yongyuxuuni/Prototyping/weekly lab report/May 15 Friday/lab report-May 15.docx

Lab Report

Date: May 15th , 2026

Team: E1

Team Members

Last name | First name | Email
Rahman | Md Mahbubur | md-mahbubur.rahman@stud.hshl.de
Sakib | Md Naimur Rahaman | md-naimur-rahaman.sakib@stud.hshl.de
Xu | Yongyu | yongyu.xu@stud.hshl.de
Koluacik | Baris | baris.koluacik@stud.hshl.de

Goal

Assemble the vehicle and test the sensors to ensure they are functioning properly.

Discussion

1. The motor is being pushed by a screw, but this has little effect, as shown in Figure 1.

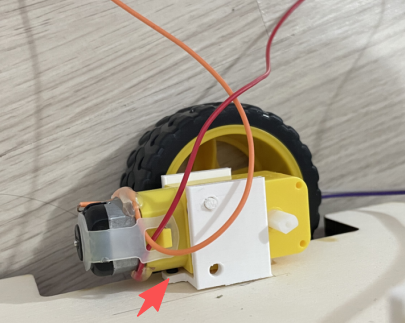
[picture p10: figure]
ee1fbc95-70e5-45c6-a6e3-75dcbe85ee12

Figure 1 The Motor Holder

2. The IR-Sensor Holders were not sturdy enough and broke during installation, it has been reprinted.
3. The chassis is too close to the ground, but no issues have been observed so far, as shown in Figure 2.

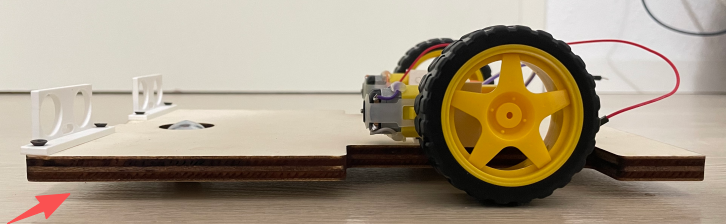
[picture p11: figure]
f93b4a24-a529-4bf4-97b0-87d33d0d764e

Figure 2 The chassis and ground

4. Both the IR-Sensors and the Ultrasonic-Sensors are functioning properly, please refer to the videos in the folder for details.

Prototyping - Summer Semester 2026
