yongyuxuuni/Prototyping/Task 1/physical schematic/Robot.pdf

L R

# HC-SR04

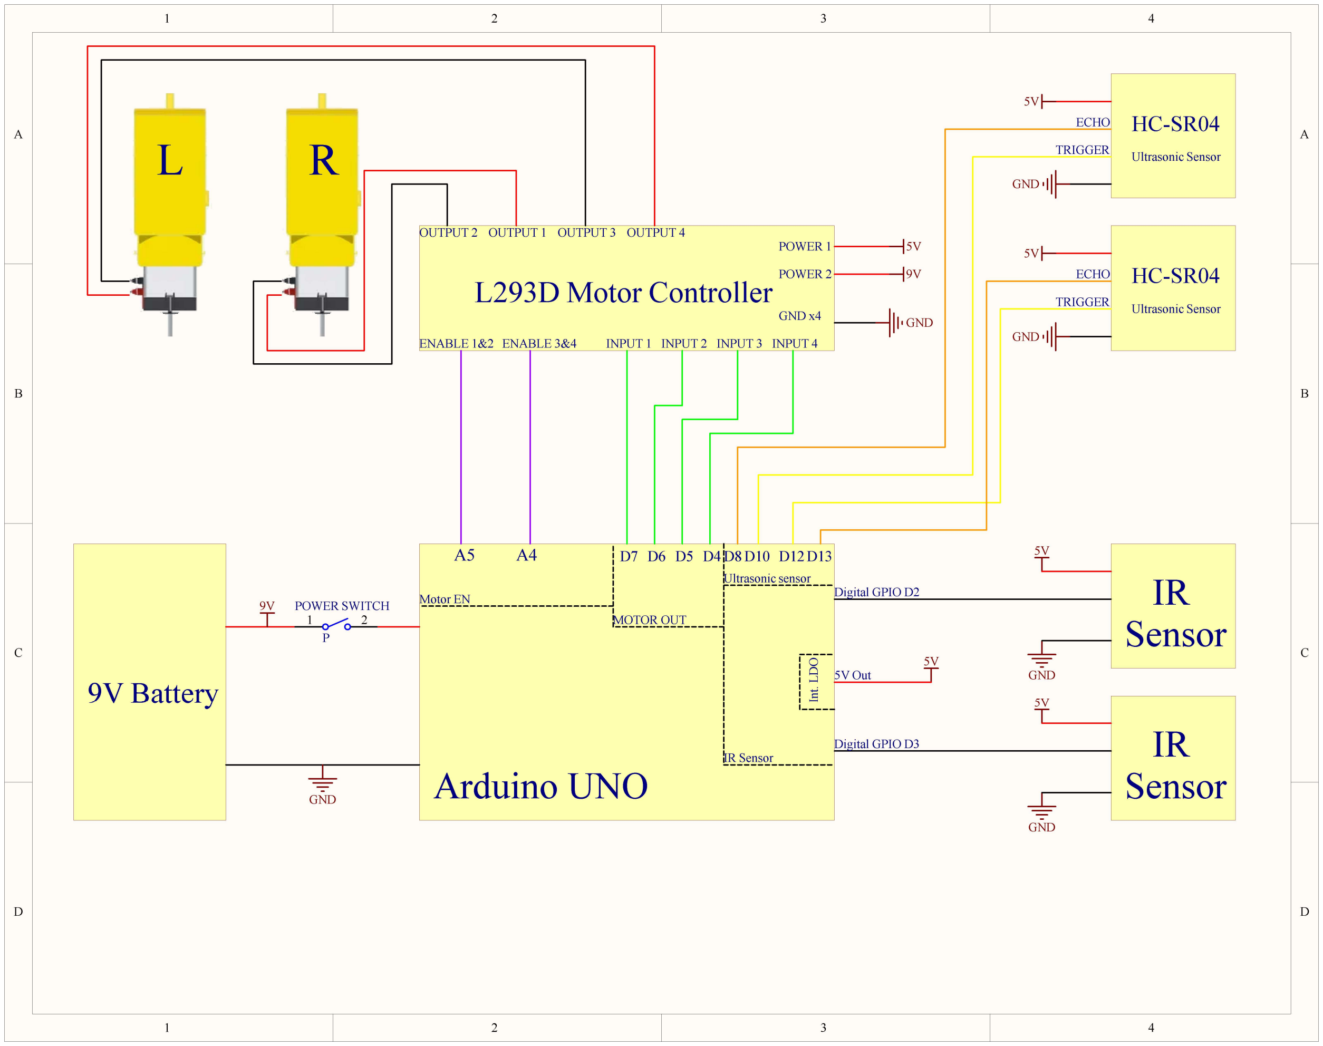
[picture p21: page 1]

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
# Arduino UNO

# 9V Battery

# L293D Motor Controller

IR

# Sensor

GND

GND

9V

5V

Digital GPIO D2

IR

# Sensor

GND

5V

Digital GPIO D3

1 2

POWER SWITCH

P
5V
5V Out
OUTPUT 2 | OUTPUT 3 OUTPUT 4 OUTPUT 1
POWER 1

POWER 2

5V

9V

GND x4 | GND

ENABLE 1&2 ENABLE 3&4

A5 A4

INPUT 1 INPUT 2 INPUT 3 INPUT 4

### D7 D6 D5 D4

Ultrasonic Sensor

5V

D8 D10

MOTOR OUT

D12 D13

ECHO

TRIGGER

GND

# HC-SR04

Ultrasonic Sensor

5V
ECHO

TRIGGER

GND

Ultrasonic sensor

IR Sensor Int. LDO

Motor EN
