yongyuxuuni/Prototyping/presentation/E1 presentation.pdf

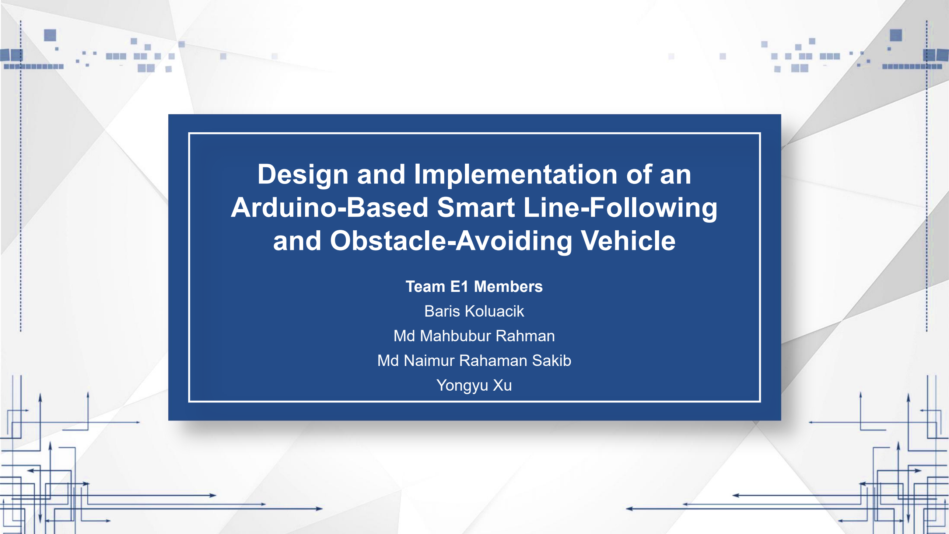
[picture p22: page 1]

# Design and Implementation of an Arduino-Based Smart Line-Following and Obstacle-Avoiding Vehicle

### Team E1 Members

Baris Koluacik
Md Mahbubur Rahman
Md Naimur Rahaman Sakib
Yongyu Xu

### https://www.ypppt.com/

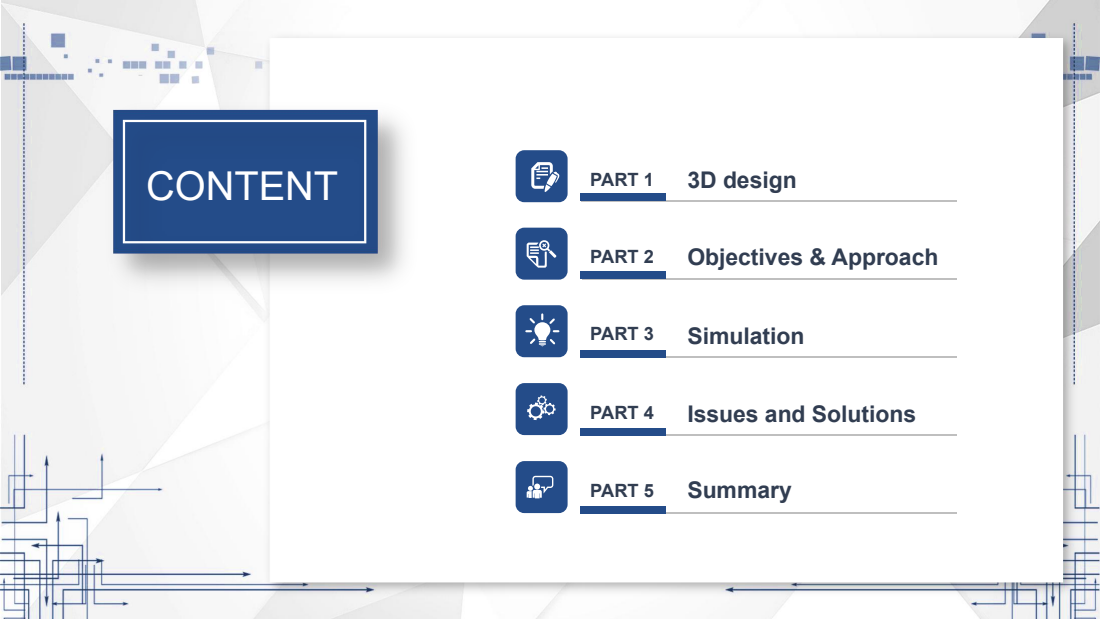
[picture p23: page 2]
CONTENT; PART 1; 3D design; PART 2; Objectives & Approach; PART 3; Simulation; PART 4; Issues and Solutions; PART 5; Summary

## PART 1 3D design

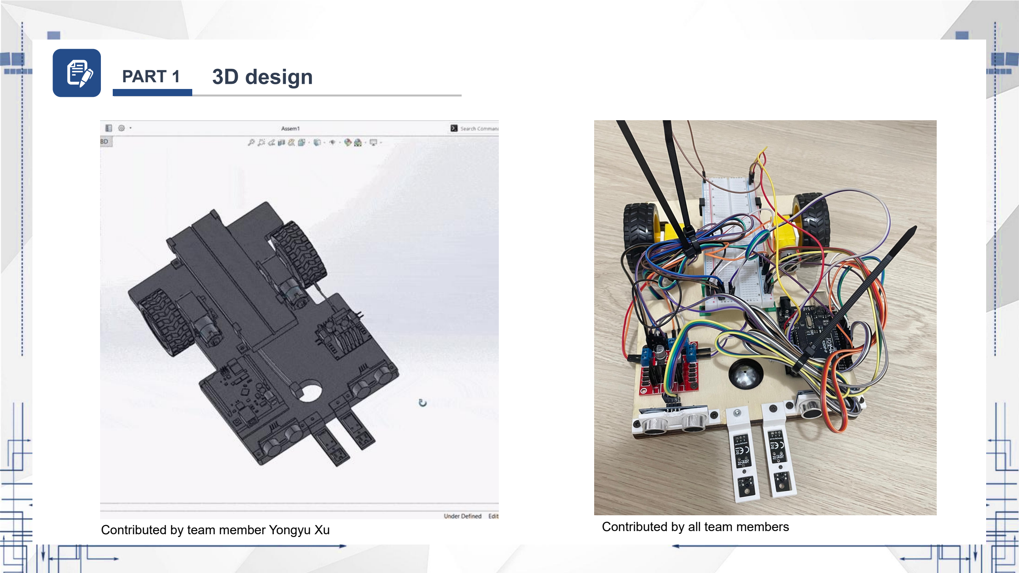
[picture p24: page 3]

Contributed by team member Yongyu Xu | Contributed by all team members

## PART 2 Objectives&Approach

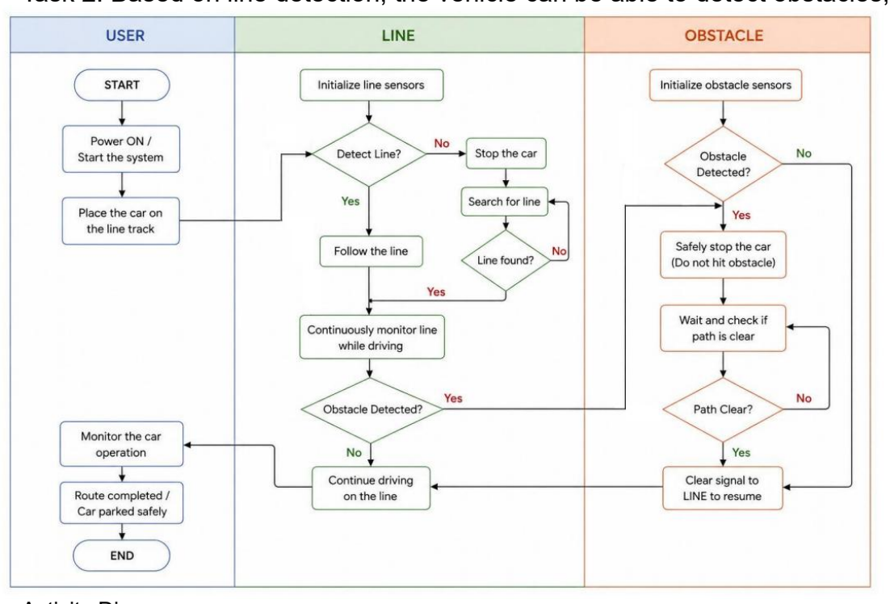
[picture p25: figure]

Activity Diagram
Contributed by team member Md Naimur Rahaman Sakib

Objectives：
Task 1: Develop an autonomous vehicle that can drive autonomously on a given track. Task 2: Based on line detection, the vehicle can be able to detect obstacles, avoid, search track. l Yes-> Stop-> Turn-> Continue tracking

l No-> Line tracking mode

## Obstacle avoidance mode

l Read IR sensors-> Move forward/Turn -> Continue tracking

## Line following mode

## PART 2 Objectives&Approach

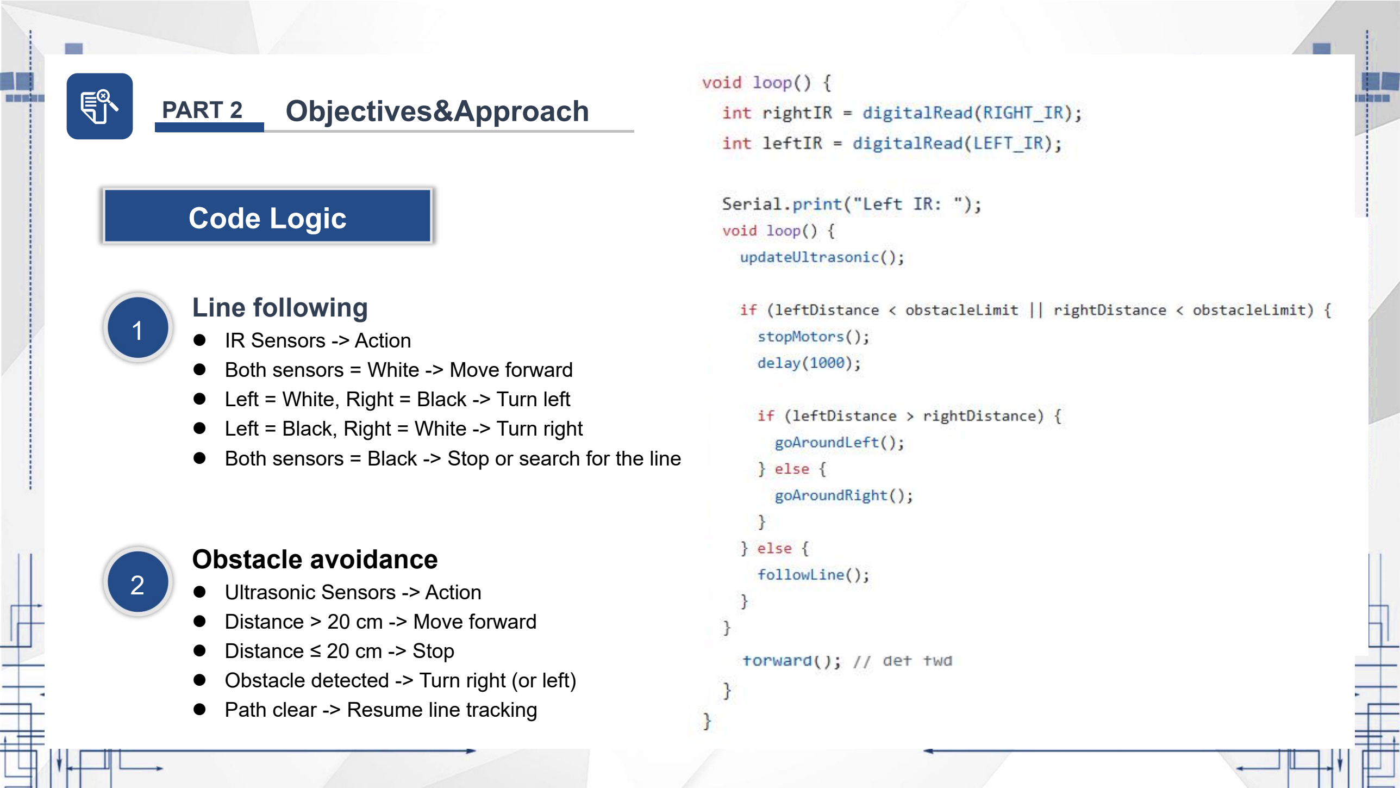
[picture p26: page 5]

1

## Line following

l IR Sensors -> Action
l Both sensors = White -> Move forward
l Left = White, Right = Black -> Turn left
l Left = Black, Right = White -> Turn right
l Both sensors = Black -> Stop or search for the line

2

## Obstacle avoidance

l Ultrasonic Sensors -> Action
l Distance > 20 cm -> Move forward
l Distance ≤ 20 cm -> Stop
l Obstacle detected -> Turn right (or left) l Path clear -> Resume line tracking

## Code Logic

## PART 2 Objectives&Approach

## Wiring Logic

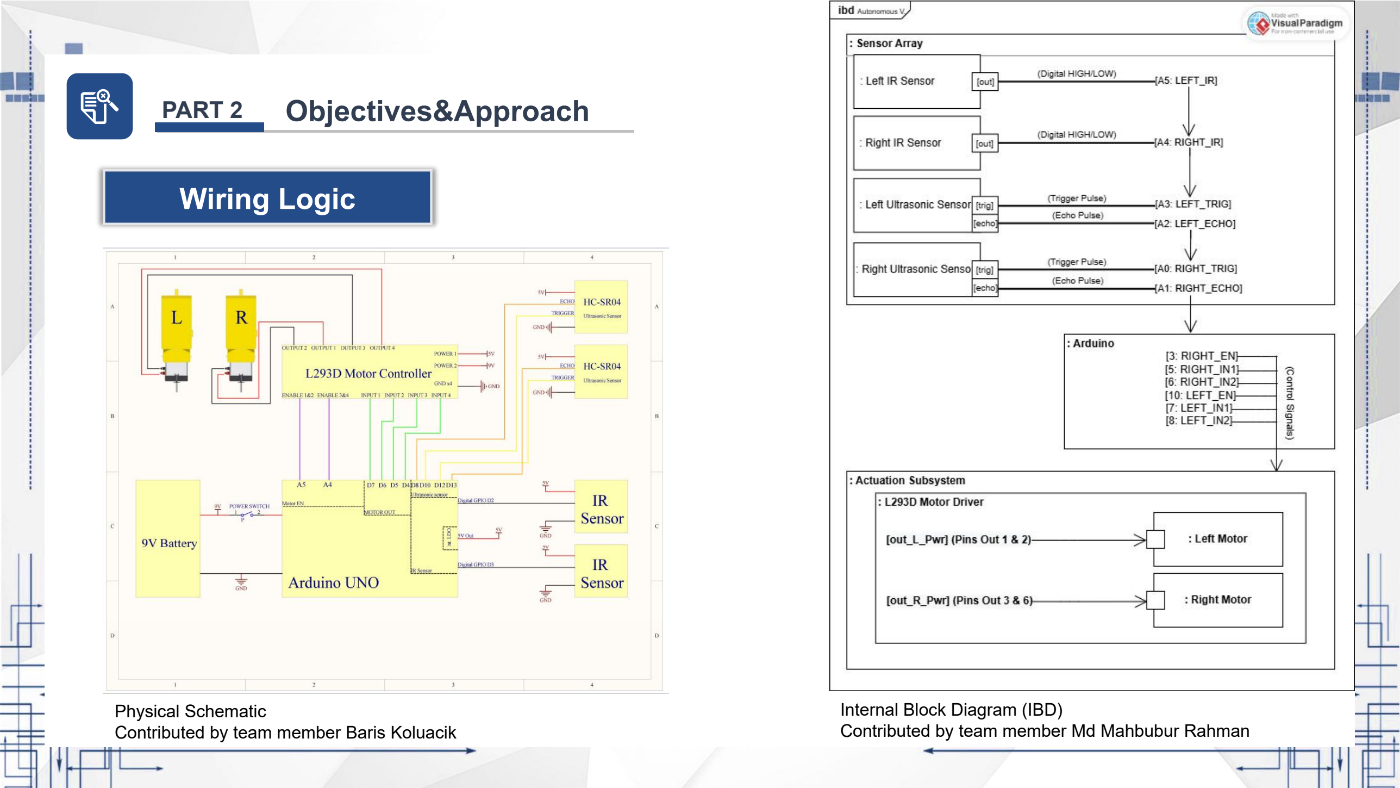
[picture p27: page 6]

Internal Block Diagram (IBD)
Contributed by team member Md Mahbubur Rahman

Physical Schematic
Contributed by team member Baris Koluacik

## PART 3 Simulation

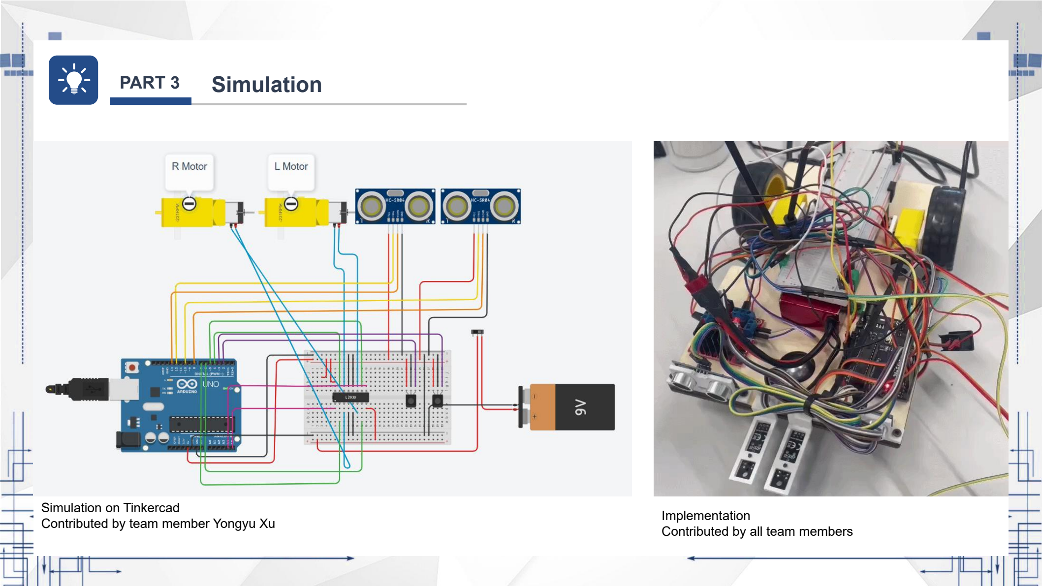
[picture p28: page 7]

Simulation on Tinkercad
Contributed by team member Yongyu Xu

Implementation
Contributed by all team members

## PART 4 Issues and Solutions

## Issues for Task 1

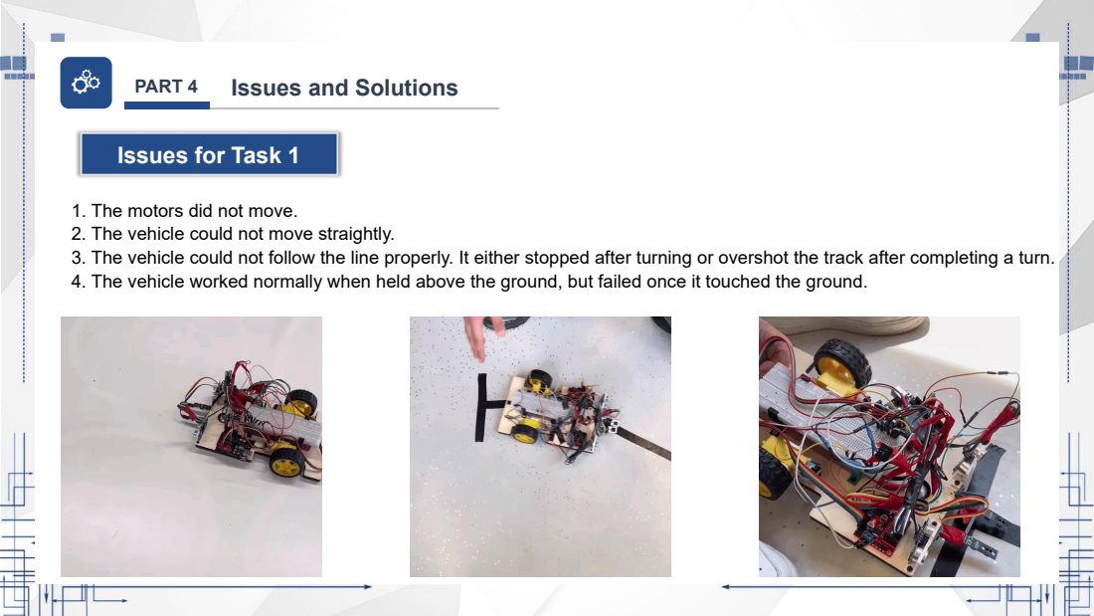
[picture p29: page 8]

1. The motors did not move. 2. The vehicle could not move straightly. 3. The vehicle could not follow the line properly. It either stopped after turning or overshot the track after completing a turn. 4. The vehicle worked normally when held above the ground, but failed once it touched the ground.

## PART 4 Issues and Solutions

## Wiring

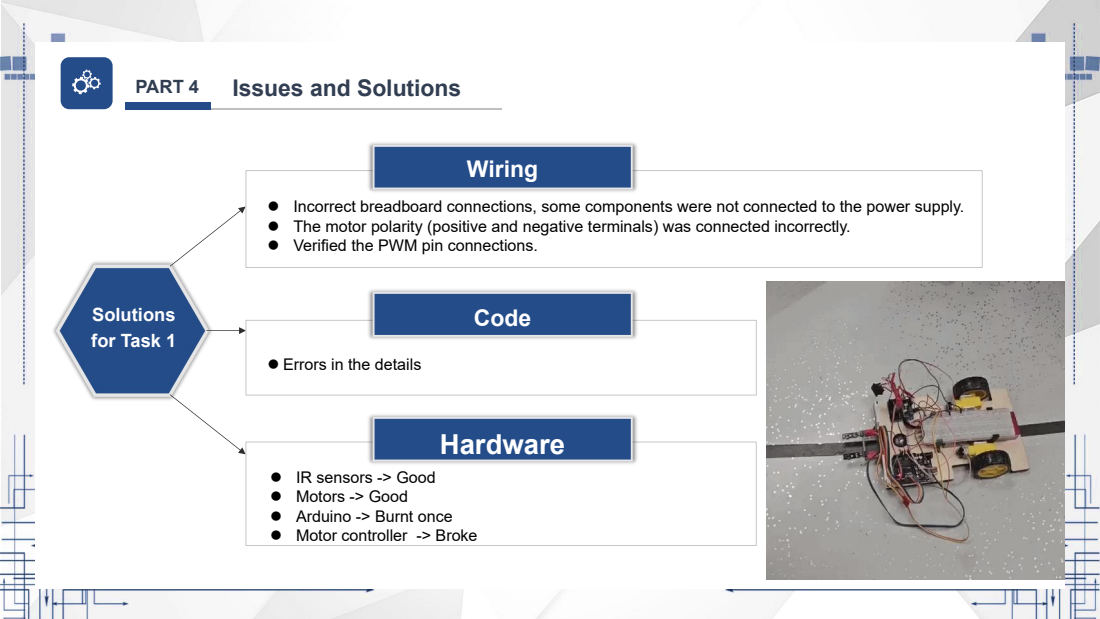
[picture p30: page 9]
Hardware; Solutions for Task 1

l Incorrect breadboard connections, some components were not connected to the power supply. l The motor polarity (positive and negative terminals) was connected incorrectly. l Verified the PWM pin connections. Code

l Errors in the details

l IR sensors -> Good
l Motors -> Good
l Arduino -> Burnt once
l Motor controller -> Broke

## PART 4 Issues and Solutions

## Issues & Solutionsfor Task 2

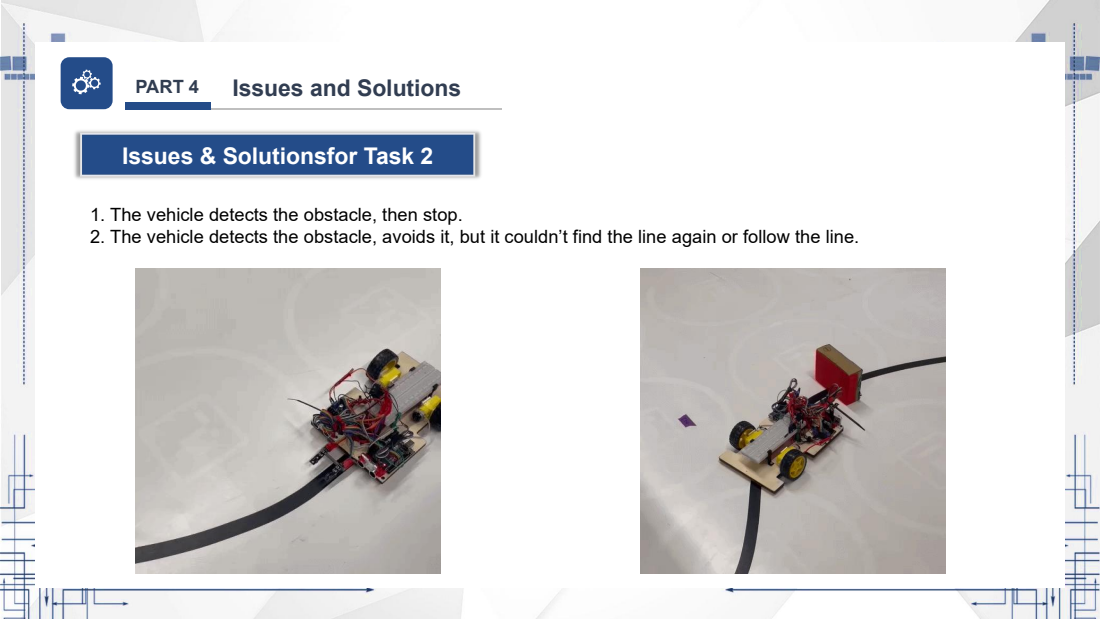
[picture p31: page 10]

1. The vehicle detects the obstacle, then stop. 2. The vehicle detects the obstacle, avoids it, but it couldn’t find the line again or follow the line.

## PART 5 Summary

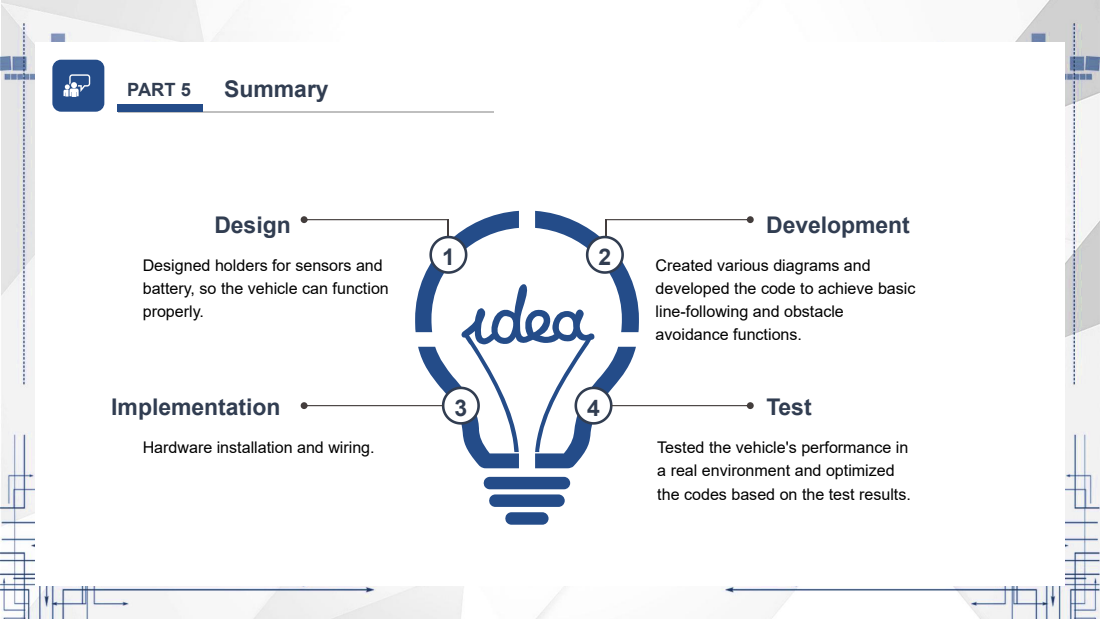
[picture p32: page 11]
Design; properly.; Development; Hardware installation and wiring.; Test

Designed holders for sensors and
battery, so the vehicle can function

Created various diagrams and
developed the code to achieve basic
line-following and obstacle

avoidance functions. Implementation

Tested the vehicle's performance in
a real environment and optimized
the codes based on the test results.

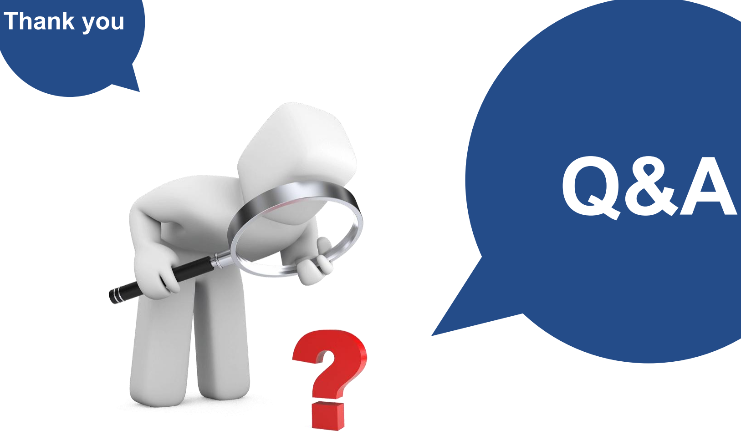
[picture p33: figure]
Q&A Thank you
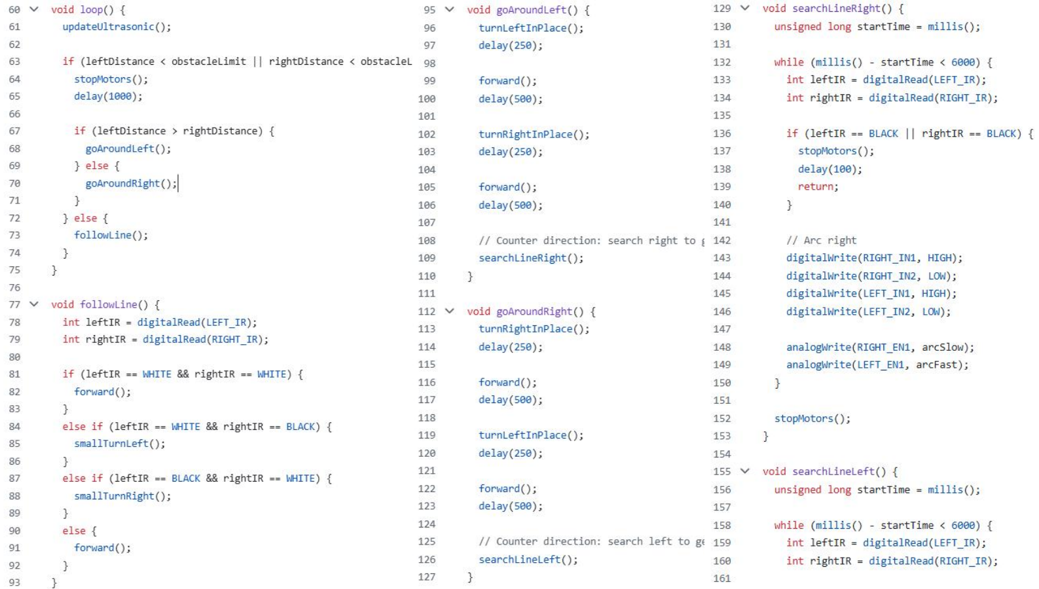
[picture p34: page 13]
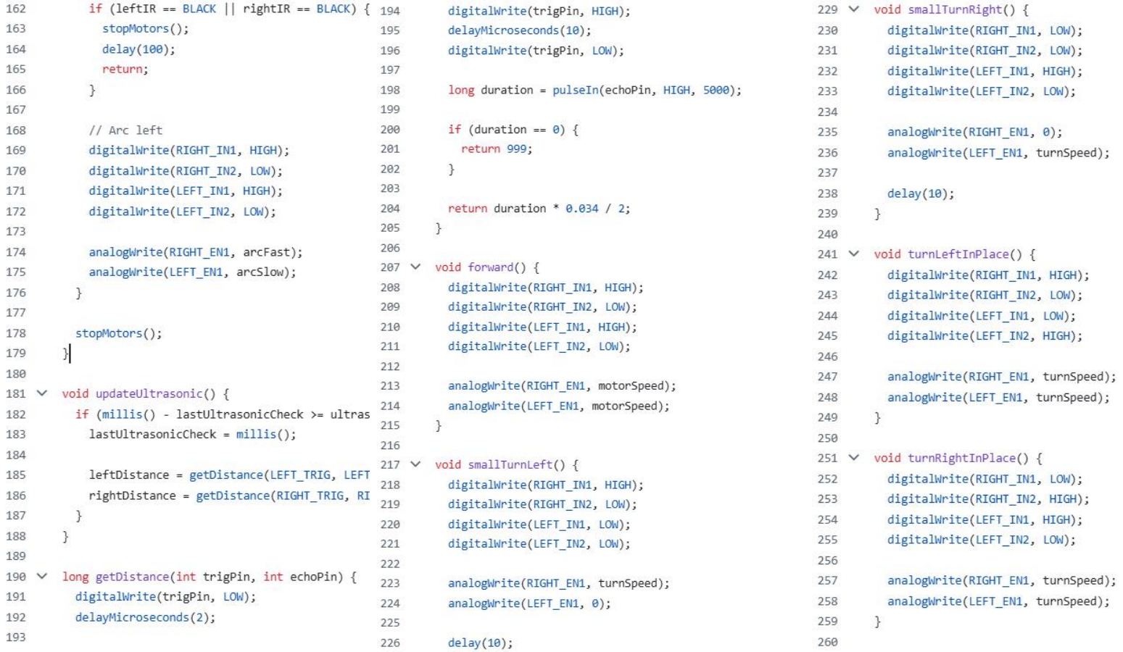
[picture p35: page 14]
