yongyuxuuni/Prototyping/weekly lab report/May 29 Friday/lab report-May 29.docx

Lab Report

Date: May 29th , 2026

Team: E1

Team Members

Last name | First name | Email
Rahman | Md Mahbubur | md-mahbubur.rahman@stud.hshl.de
Sakib | Md Naimur Rahaman | md-naimur-rahaman.sakib@stud.hshl.de
Xu | Yongyu | yongyu.xu@stud.hshl.de
Koluacik | Baris | baris.koluacik@stud.hshl.de

Goal

1.Create the first version of SysML diagrams for your vehicle project (github).

2. Create initial design and first code draft in Tinkercad (design+code)

Discussion

1. The initial design draft in Tinkercad.

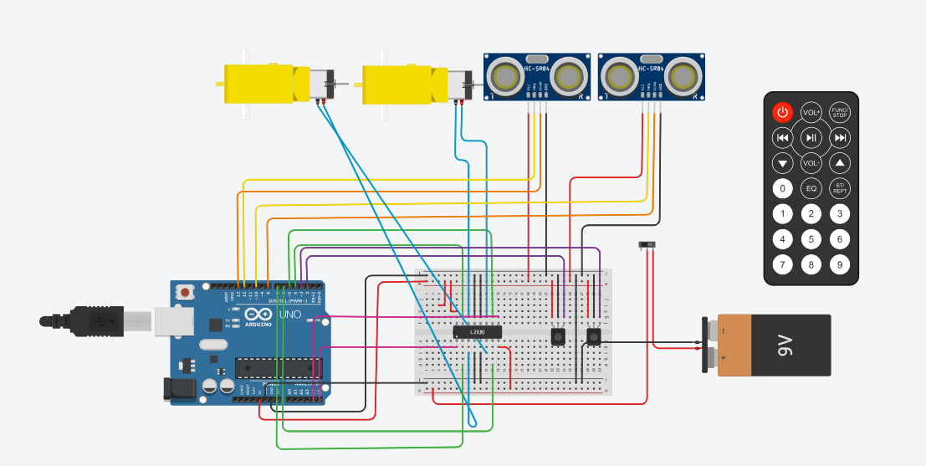
[picture p36: figure]

Figure 1 initial design draft in Tinkercad

2.The first code draft in Tinkercad is functioning properly, please refer to the codes in the folder for details.(Folder name : first-codes)

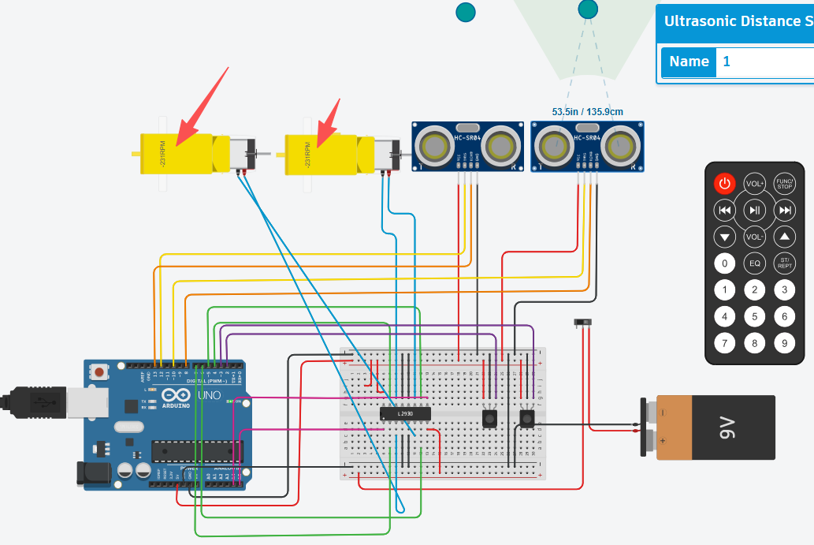
[picture p37: figure]
b4323687-9c50-4f5f-8aa6-35b17cd796d7

Figure 2 initial design draft in Tinkercad can function properly

3.Sequence Diagram(First Draft)

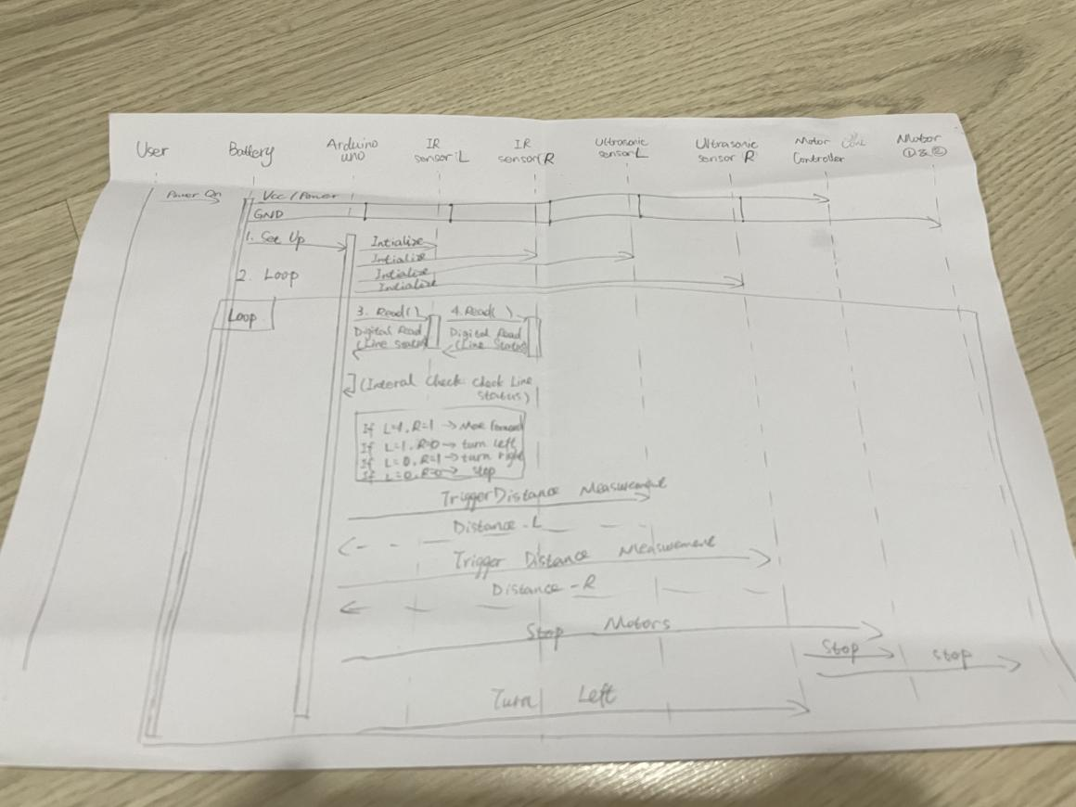
[picture p38: figure]
Sequence Diagram(First Draft)-May 29

Figure 3 Sequence Diagram(First Draft)

Prototyping - Summer Semester 2026
