yongyuxuuni/Prototyping/Task 1/Diagrams/Requirement Diagram/Requirement Diagram First Draft.pdf

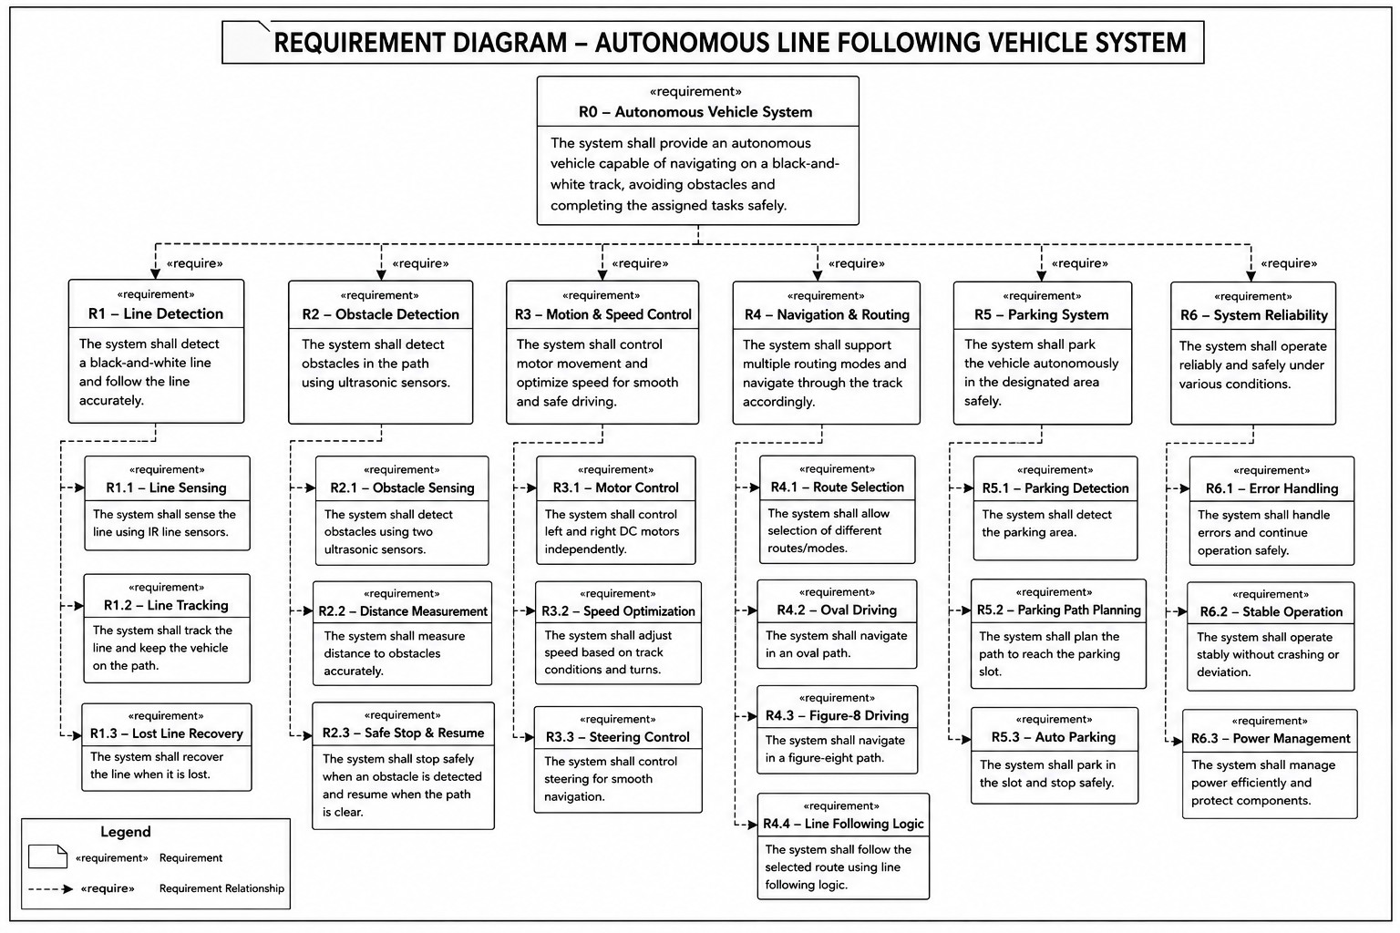
[picture p39: page 1]
