yongyuxuuni/Prototyping/Task 1/Diagrams/Requirement Diagram/Requirement Diagram Updated 30 may.pdf

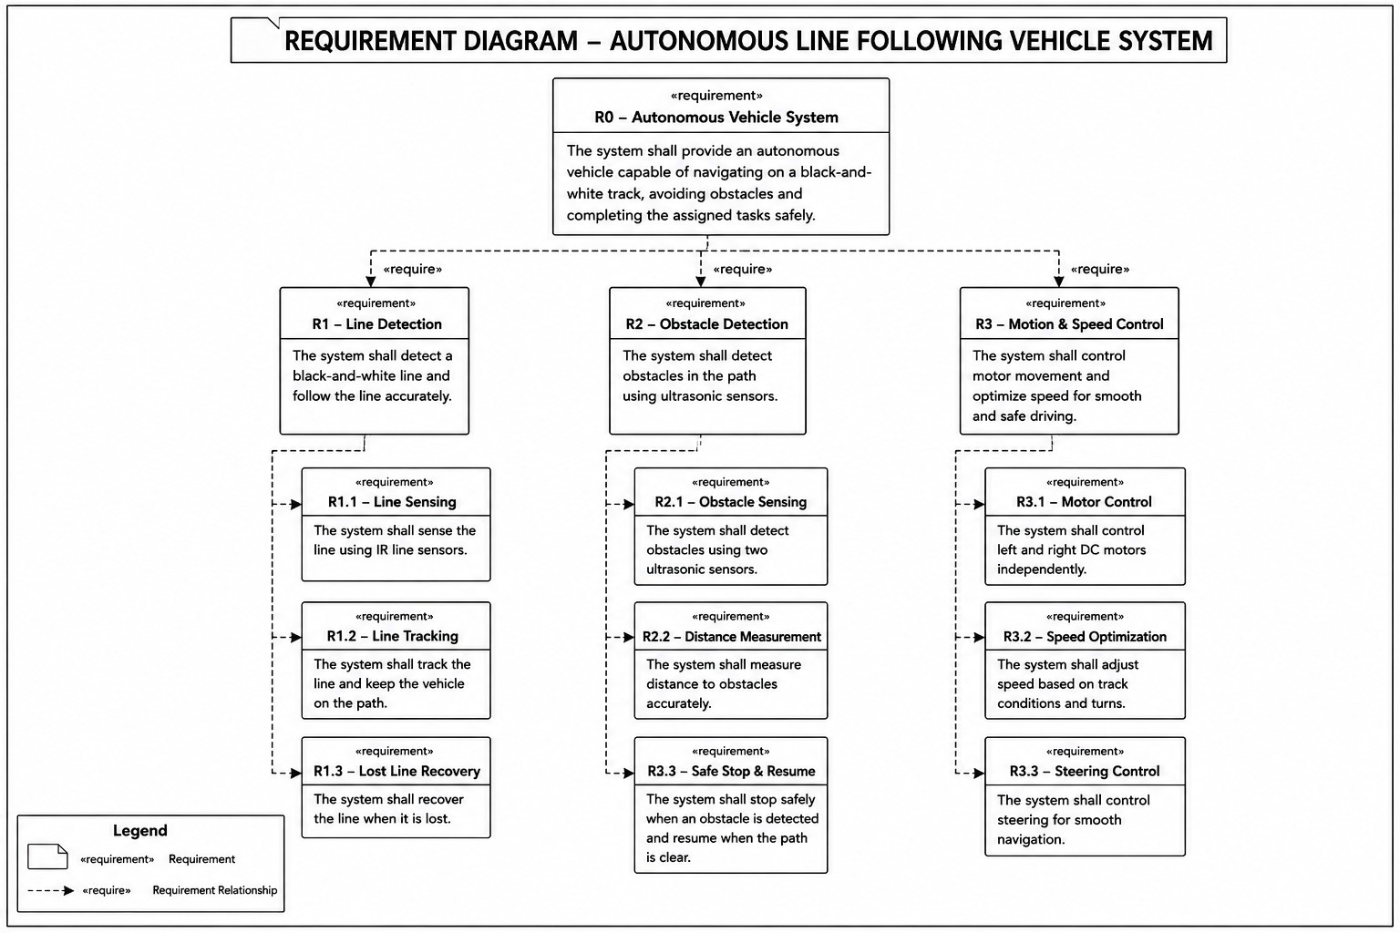
[picture p40: page 1]
