yongyuxuuni/Prototyping/Task 1/Diagrams/Activity Diagram/Activity Diagram Handout 23 May.pdf

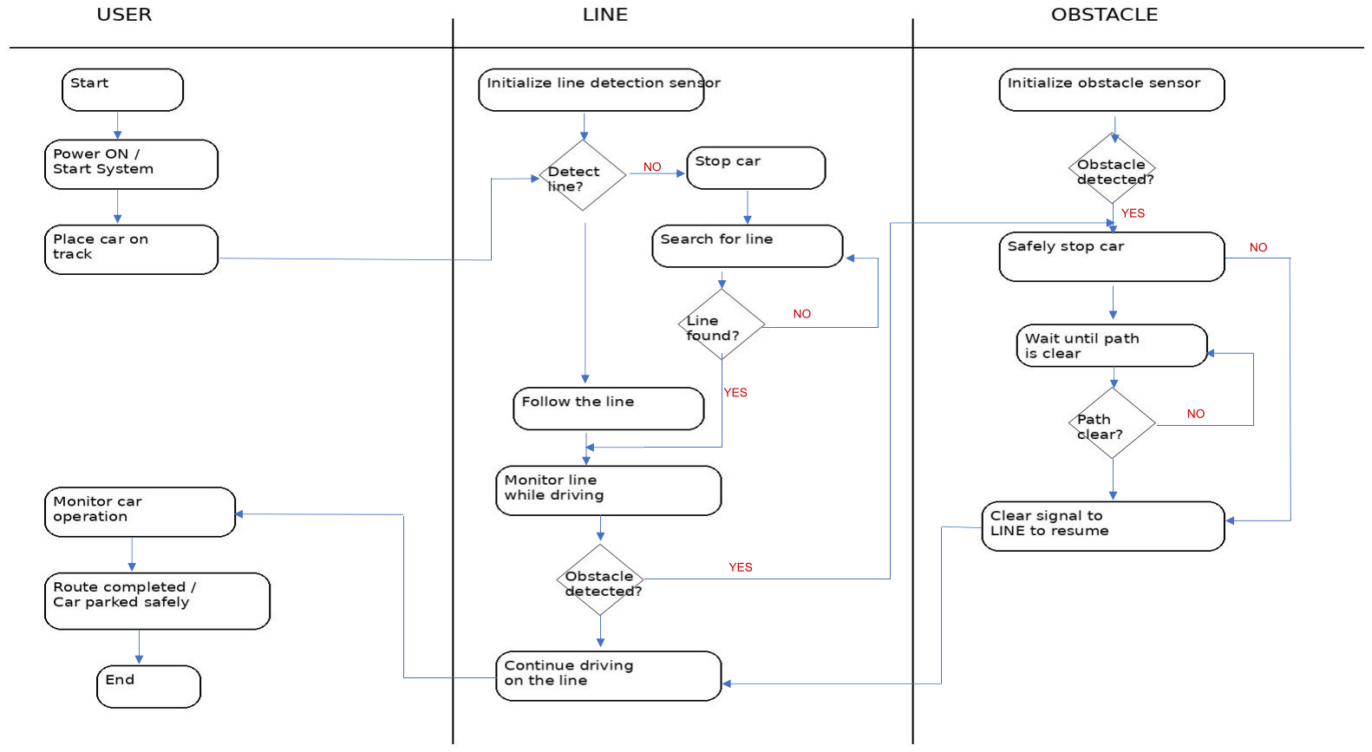
[picture p41: page 1]
