yongyuxuuni/Prototyping/Task 1/Diagrams/Packaged Diagram/Packaged Diagram 23 May.pdf

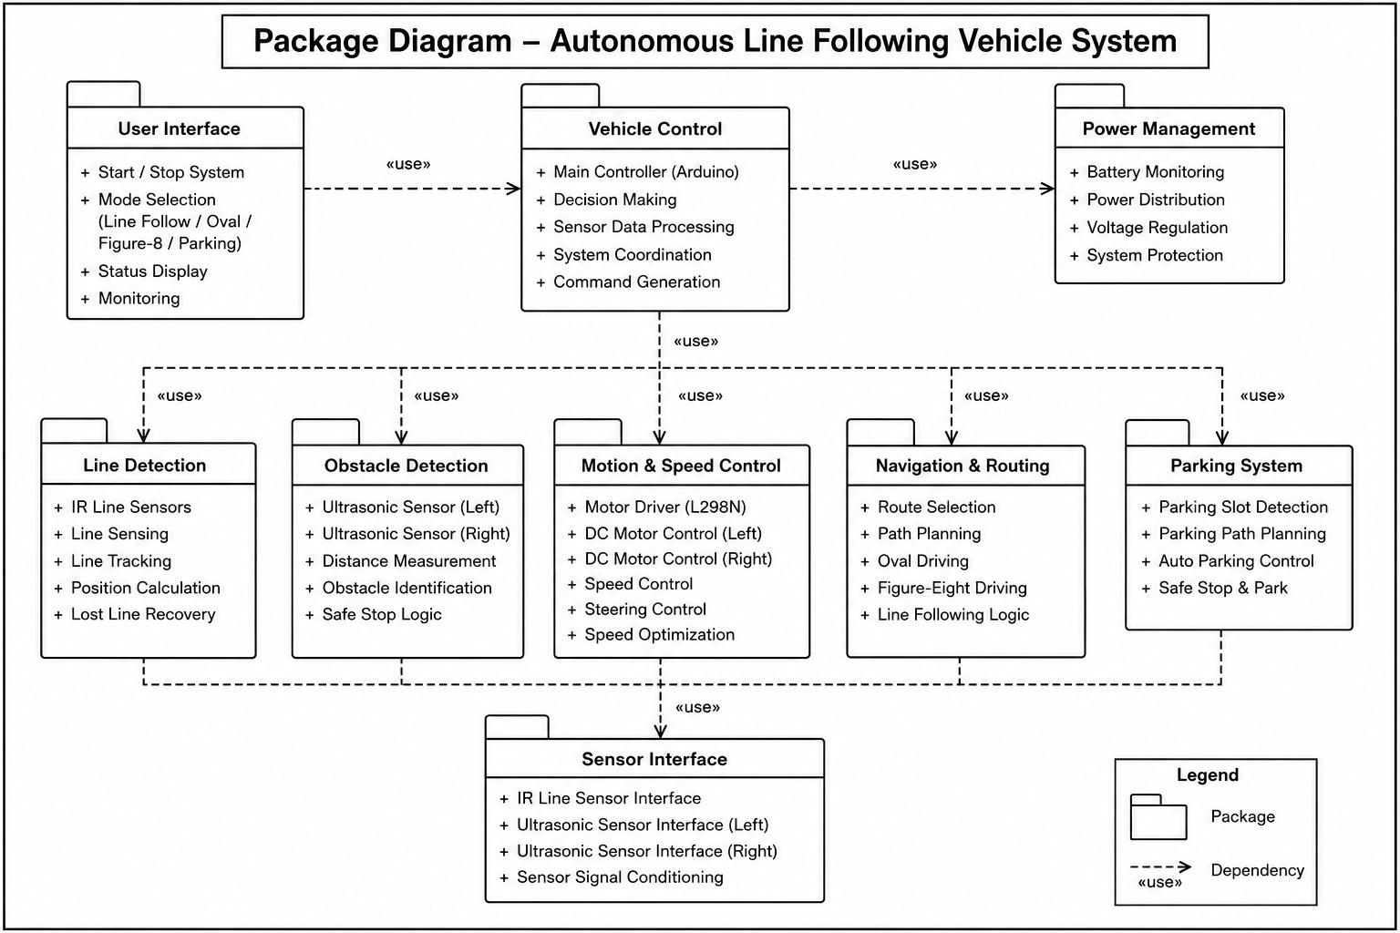
[picture p42: page 1]
