yongyuxuuni/Prototyping/Task 1/Diagrams/Packaged Diagram/Packaged Diagram Updated 30 May.pdf

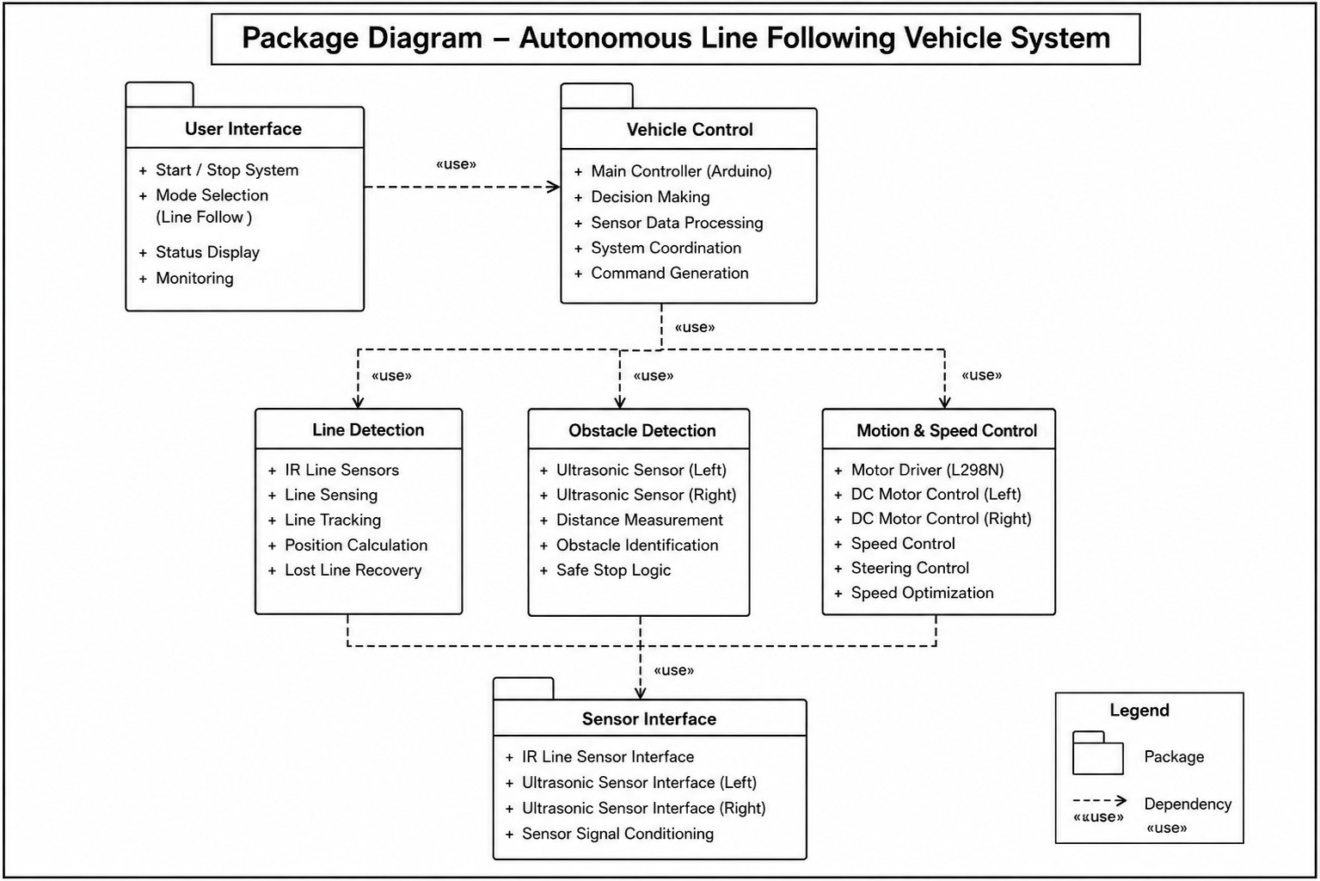
[picture p43: page 1]
