yongyuxuuni/Prototyping/Task 1/Diagrams/Activity Diagram/Activity Diagram.pdf

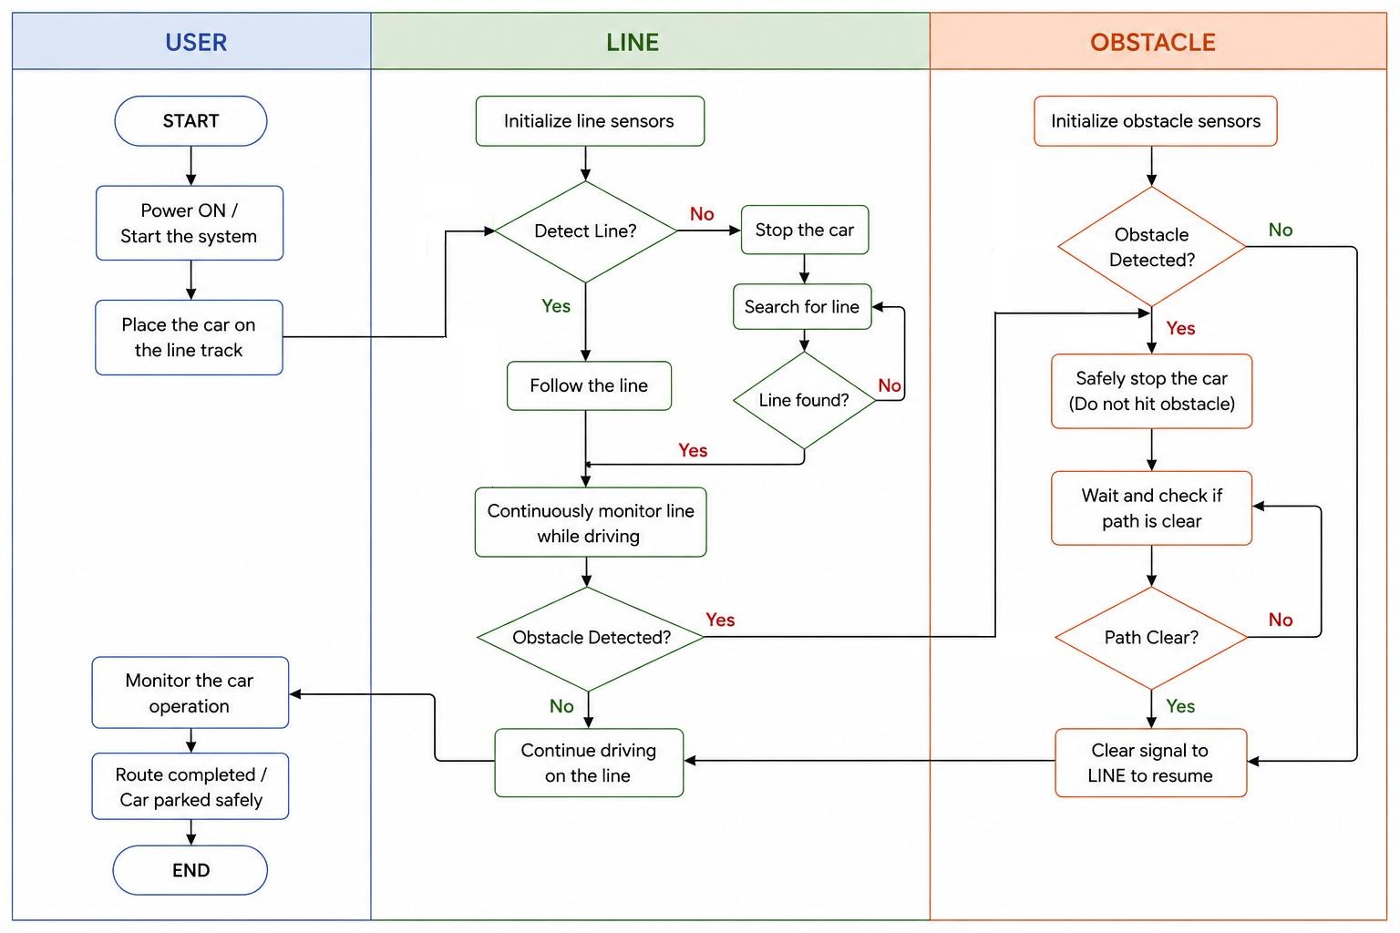
[picture p44: page 1]
