yongyuxuuni/Prototyping/E1 Task schedule.JPG

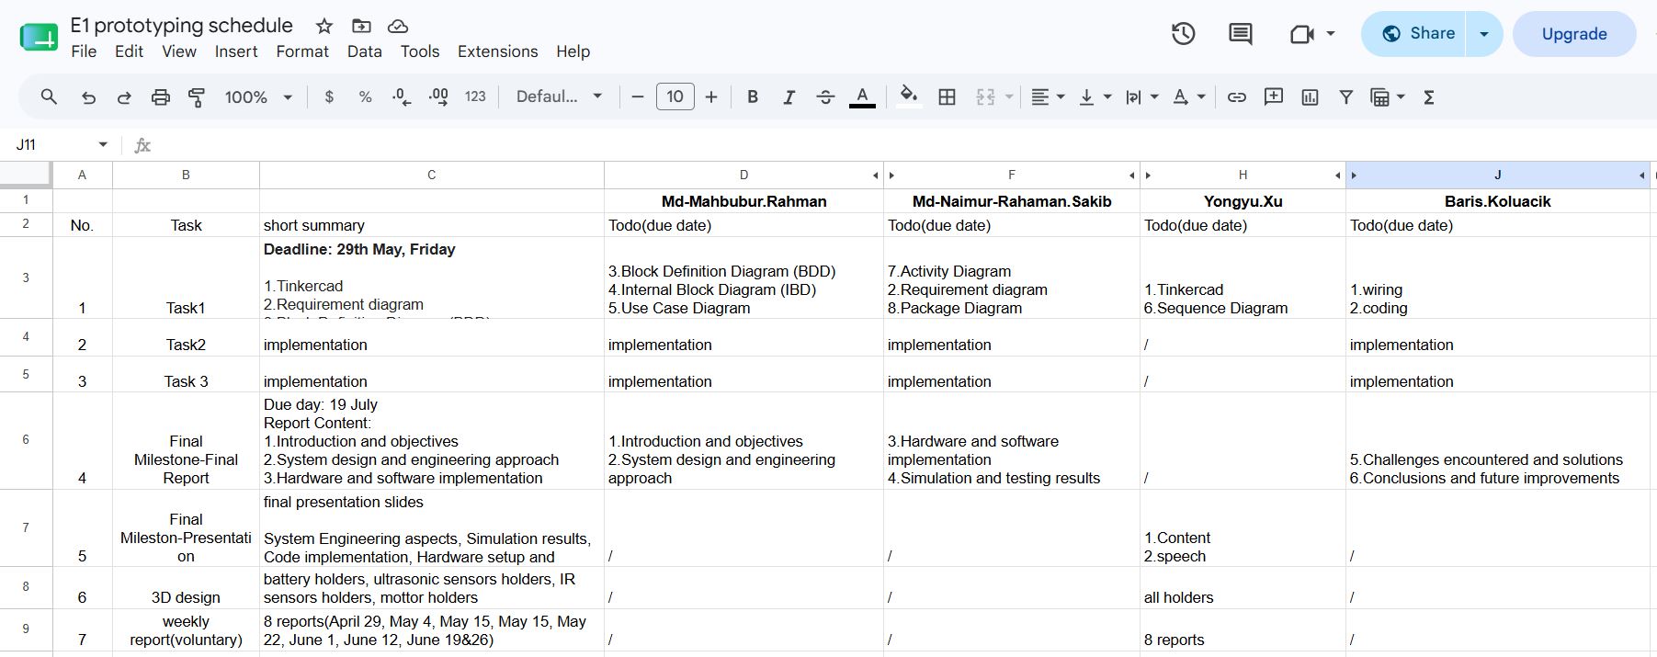
E1 Task schedule.JPG
