yongyuxuuni/Prototyping/Task 1/Diagrams/Block Definition Diagram (BDD)/Block Definition Diagram (BDD)- Prototyping.png

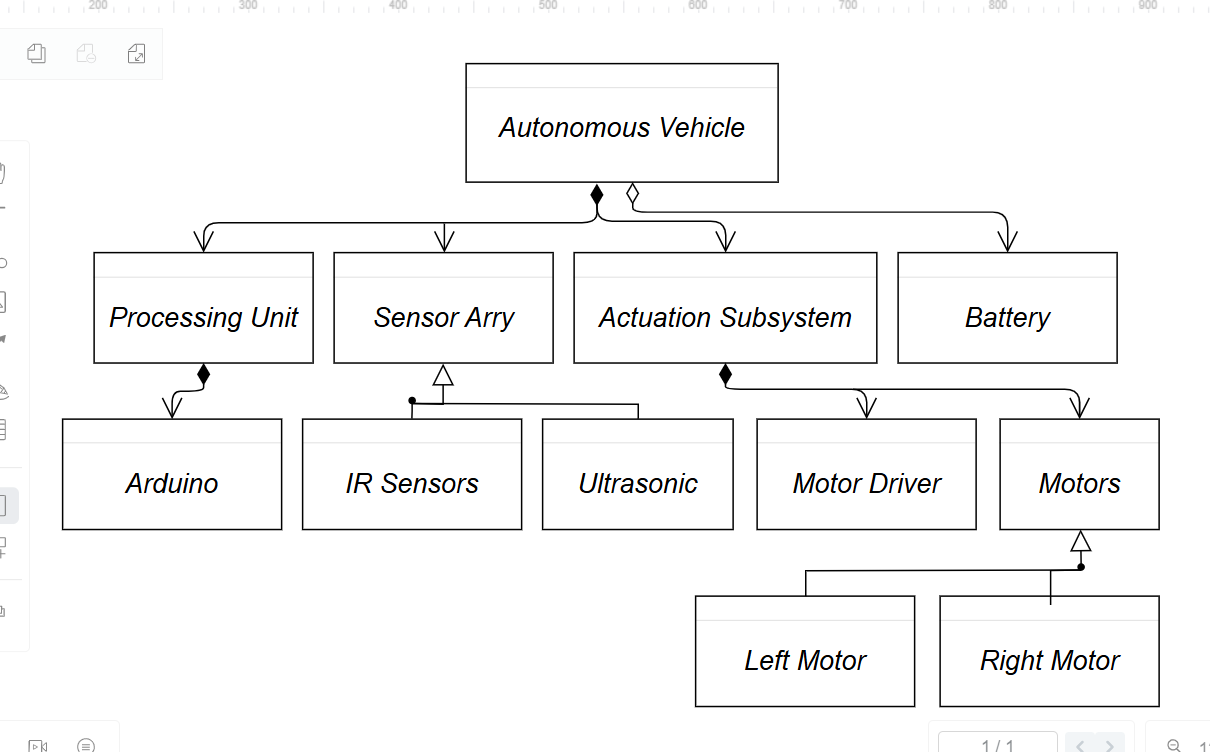
Task 1/Diagrams/Block Definition Diagram (BDD)/Block Definition Diagram (BDD)- Prototyping.png
