yongyuxuuni/Prototyping/Task 1/Diagrams/Internal Block Diagram (IBD)/Internal Block Diagram (IBD)- Prototyping.png

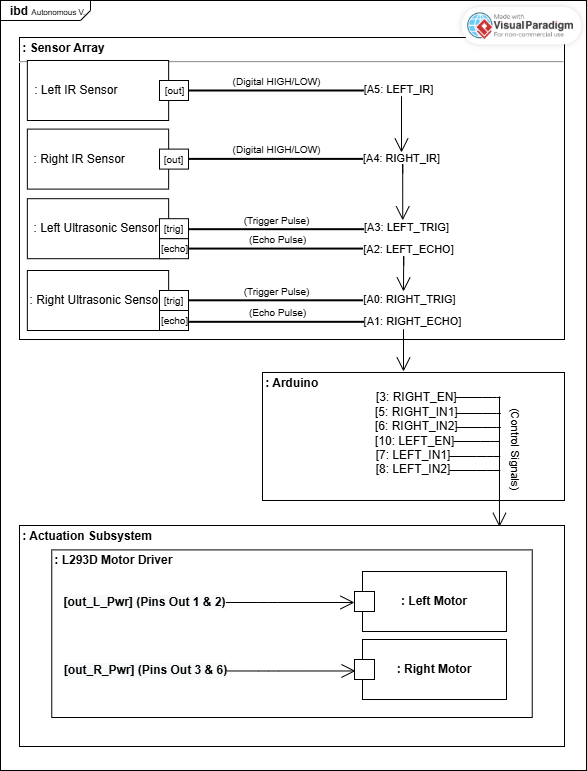
Task 1/Diagrams/Internal Block Diagram (IBD)/Internal Block Diagram (IBD)- Prototyping.png
