yongyuxuuni/Prototyping/Task 1/Diagrams/Sequence Diagram/sequence diagram (1).jpg

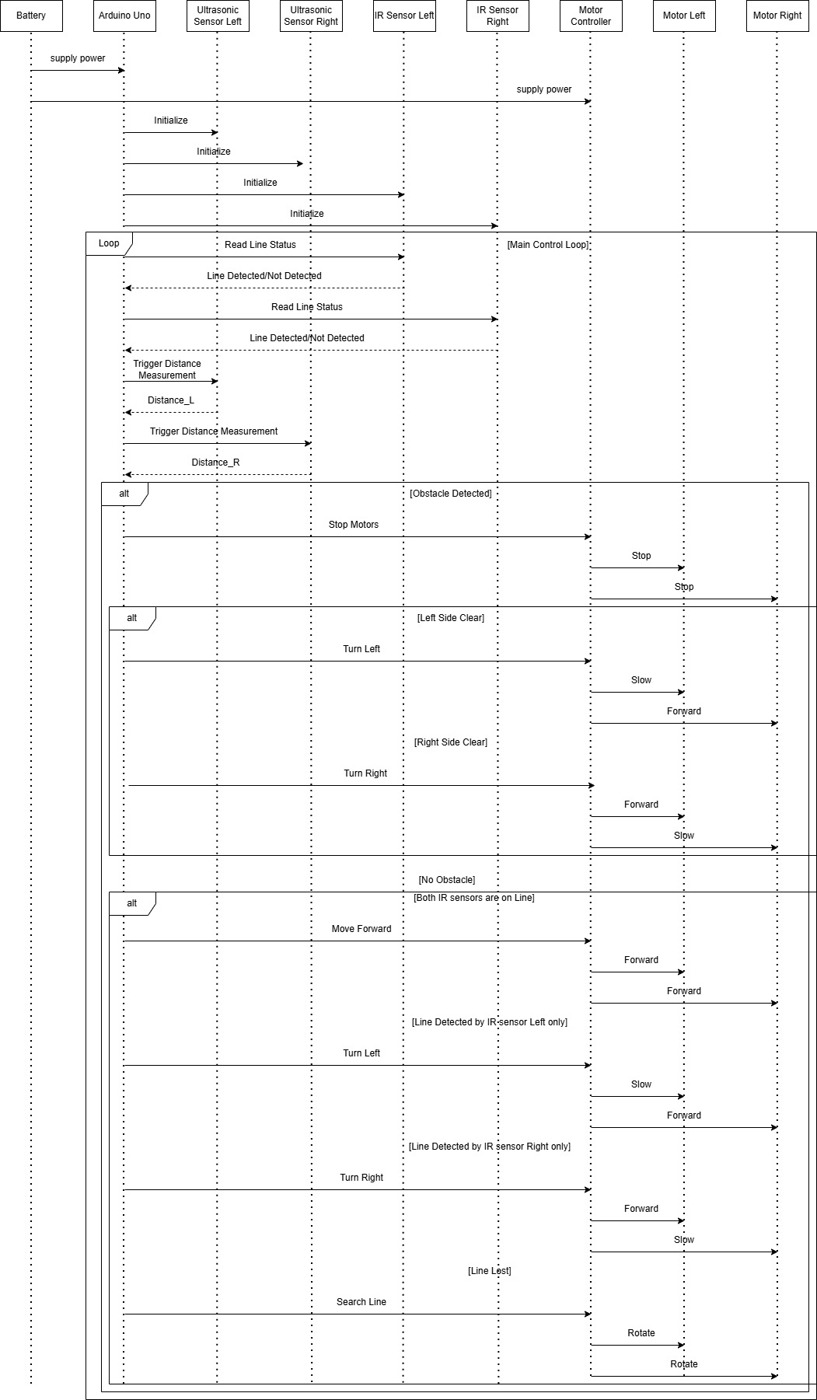
Task 1/Diagrams/Sequence Diagram/sequence diagram (1).jpg
