yongyuxuuni/Prototyping/Task 1/Diagrams/Use Case Diagram/Use Case Diagram- Prototyping.png

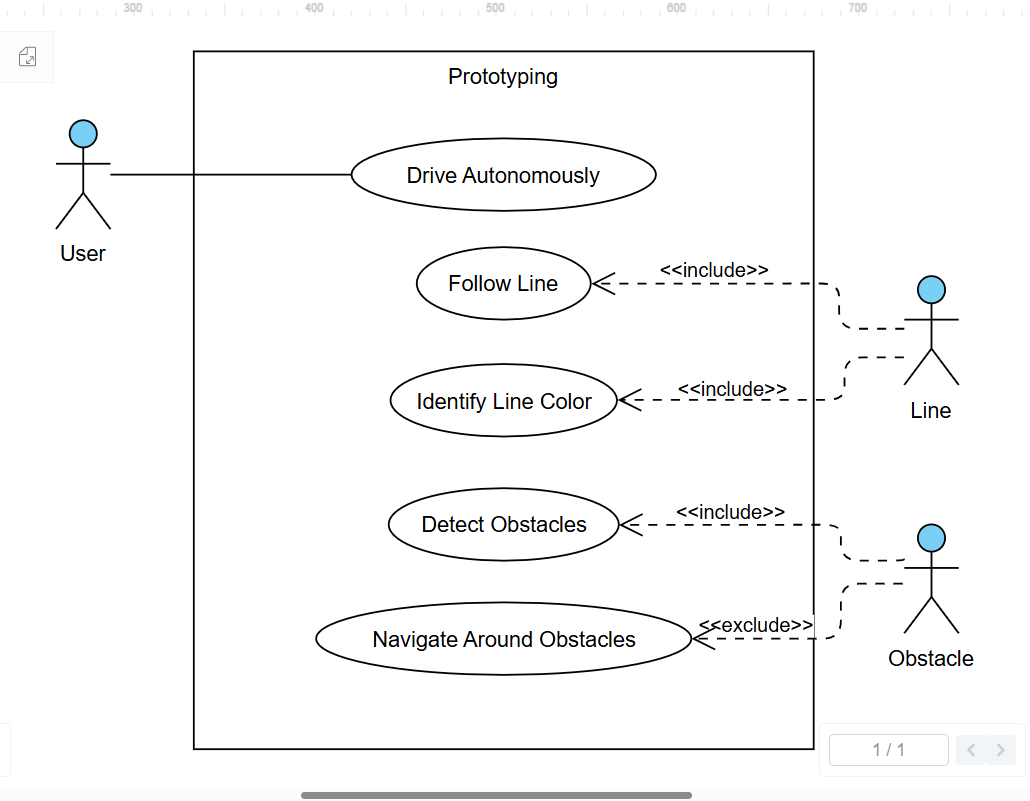
Task 1/Diagrams/Use Case Diagram/Use Case Diagram- Prototyping.png
