yongyuxuuni/Prototyping/Task 1/initial design  in Tinkercad.png

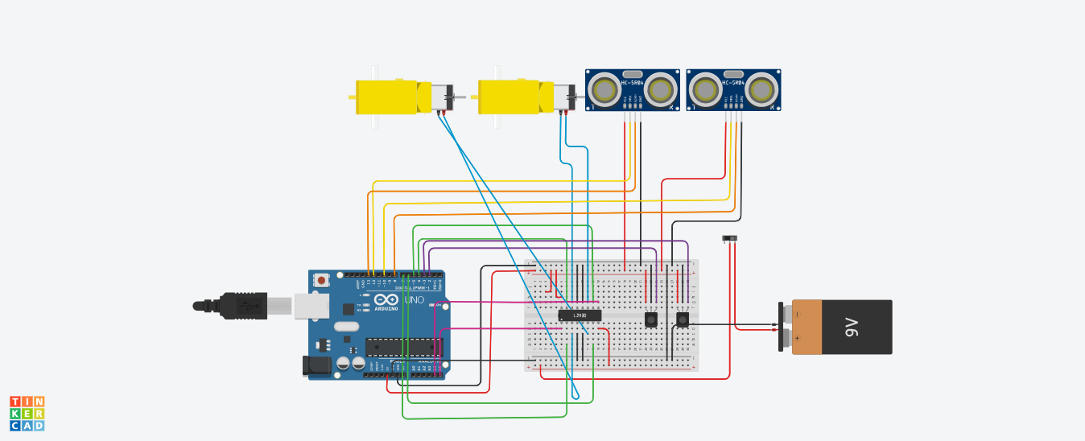
Task 1/initial design in Tinkercad.png
