yongyuxuuni/Prototyping/Design/E1/draft/new /ultrasonic holder.SLDPRT

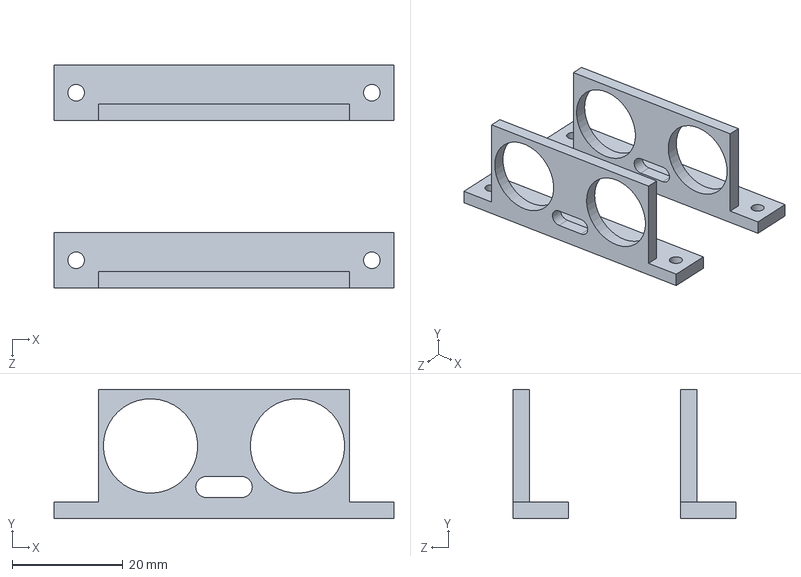
[picture p51: CAD file, 2026-05-18]
Design/E1/draft/new /ultrasonic holder.SLDPRT
61.3 x 23.3 x 40.2 mm
