yongyuxuuni/Prototyping/Design/E1/E1-STP /E1-battery holder.STEP

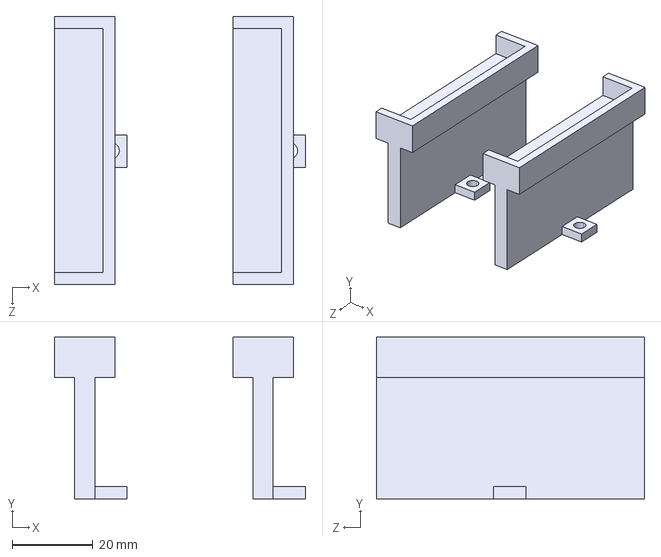
[picture p52: CAD file, 2026-05-18]
Design/E1/E1-STP /E1-battery holder.STEP
62.1 x 40.0 x 66.3 mm
