yongyuxuuni/Prototyping/May 4 Monday/E1/draft/battery holder2.SLDPRT

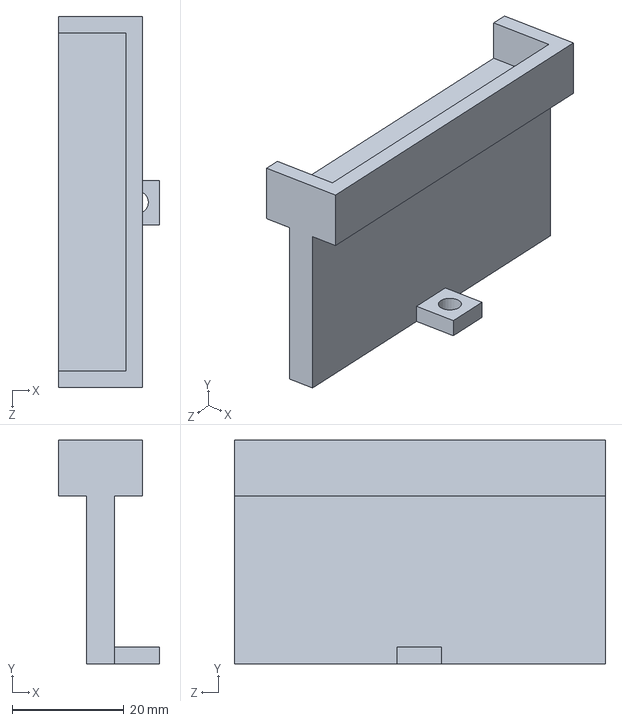
[picture p53: CAD file, 2026-05-18]
May 4 Monday/E1/draft/battery holder2.SLDPRT
18.0 x 40.0 x 66.3 mm
