yongyuxuuni/Prototyping/May 4 Monday/E1/draft/ul holder2.SLDPRT

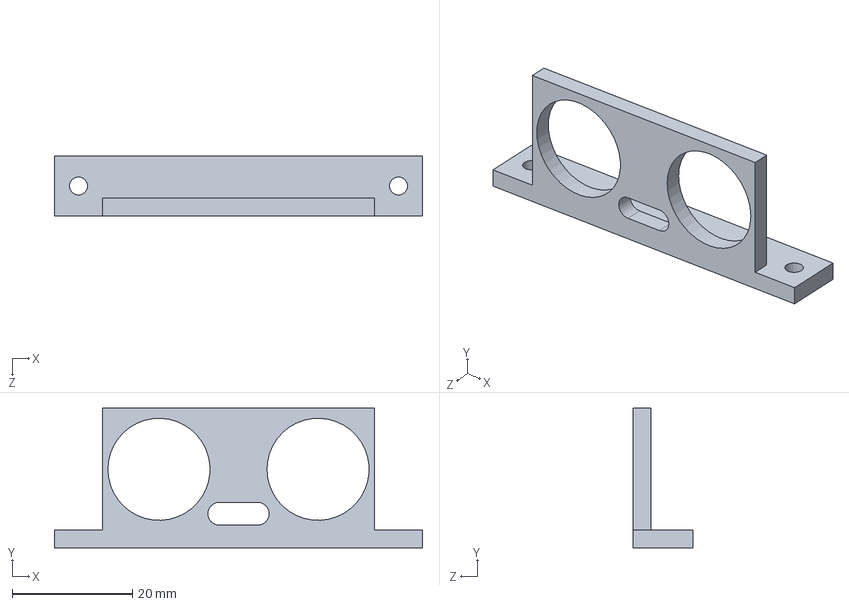
[picture p54: CAD file, 2026-05-18]
May 4 Monday/E1/draft/ul holder2.SLDPRT
61.3 x 23.3 x 10.0 mm
