yongyuxuuni/Prototyping/Design/E1/draft/new /motor holder.SLDPRT

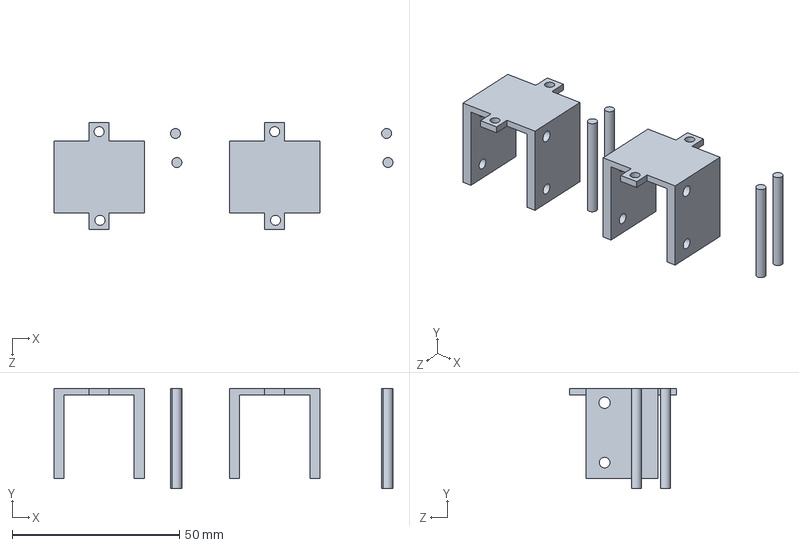
[picture p55: CAD file, 2026-05-18]
Design/E1/draft/new /motor holder.SLDPRT
101.4 x 30.0 x 32.0 mm
