yongyuxuuni/Prototyping/May 4 Monday/E1/draft/ir sensor holder2.SLDPRT

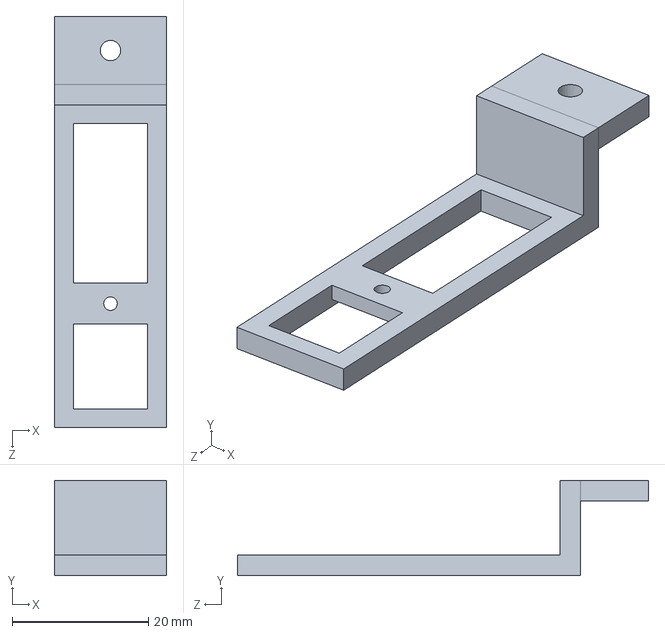
[picture p56: CAD file, 2026-05-18]
May 4 Monday/E1/draft/ir sensor holder2.SLDPRT
16.5 x 14.0 x 60.4 mm
