yongyuxuuni/Prototyping/Design/E1/draft/new /ir sensor holder.SLDPRT

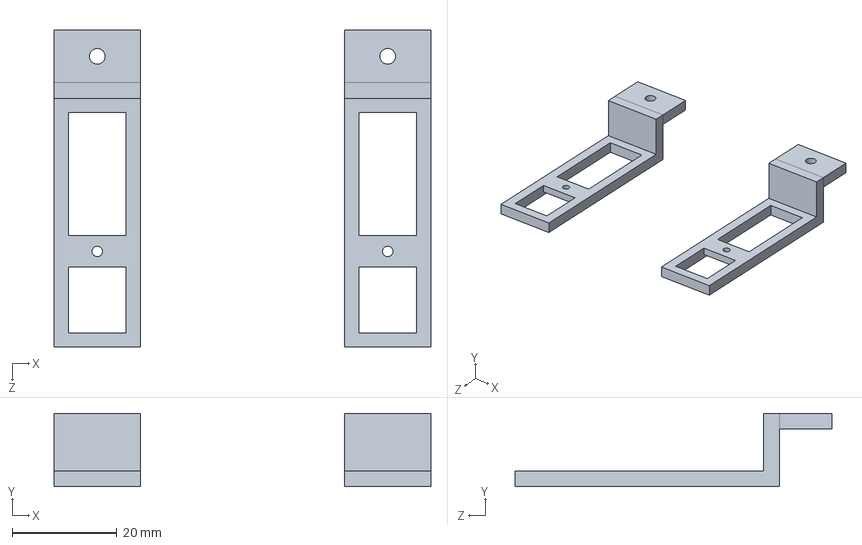
[picture p57: CAD file, 2026-05-18]
Design/E1/draft/new /ir sensor holder.SLDPRT
71.9 x 14.0 x 60.4 mm
