yongyuxuuni/Prototyping/May 4 Monday/E1/draft/motor-right.SLDPRT

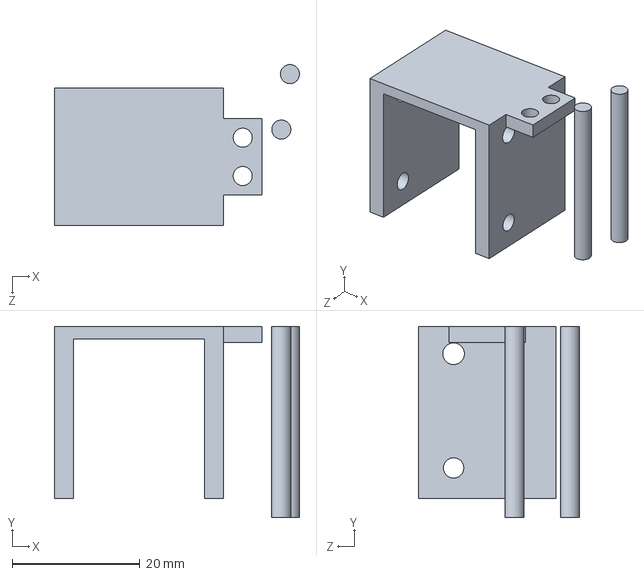
[picture p58: CAD file, 2026-05-18]
May 4 Monday/E1/draft/motor-right.SLDPRT
38.4 x 30.0 x 25.2 mm
