yongyuxuuni/Prototyping/May 4 Monday/E1/draft/motor-left.SLDPRT

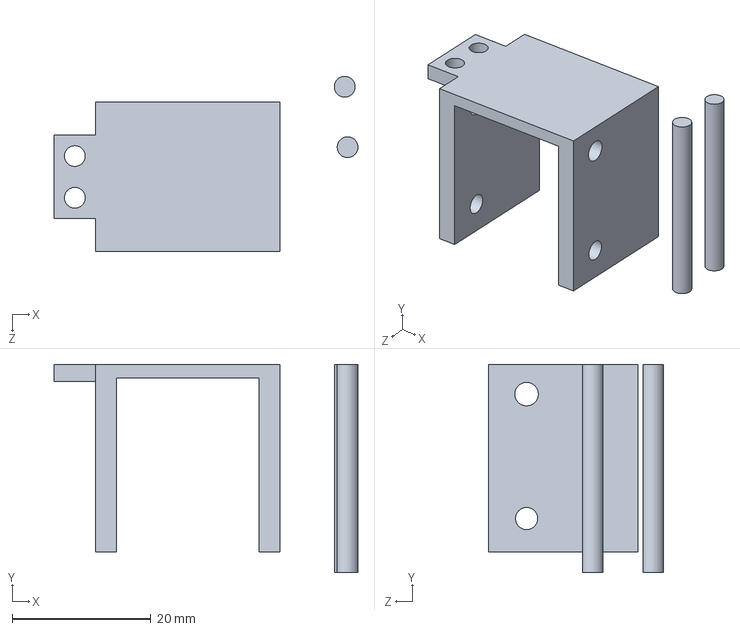
[picture p59: CAD file, 2026-05-18]
May 4 Monday/E1/draft/motor-left.SLDPRT
43.8 x 30.0 x 25.2 mm
