yongyuxuuni/Prototyping/May 4 Monday/E1/draft/Assemble.SLDASM

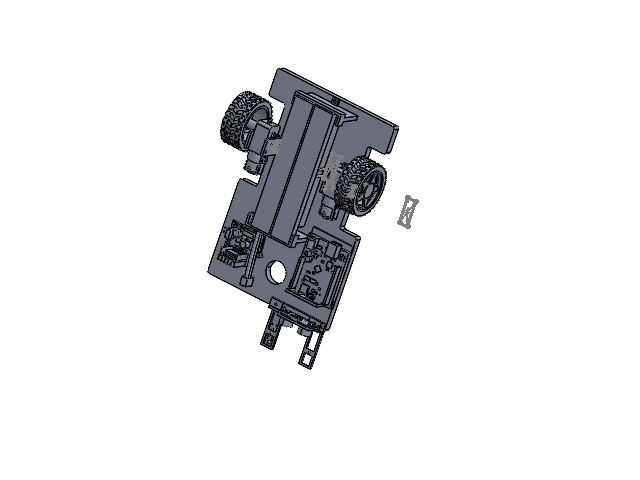
[picture p60: CAD file, 2026-05-18]
May 4 Monday/E1/draft/Assemble.SLDASM
arduino
battery
breadboard
chassis
IR sensors
motor controller
motor with tire
motor with tire2
ultrasonic sensors
battery holder2 x 2
ul holder1
ir sensor holder1
motor-front x 2
