yongyuxuuni/Prototyping/May 4 Monday/E1/draft/Assem1.SLDASM

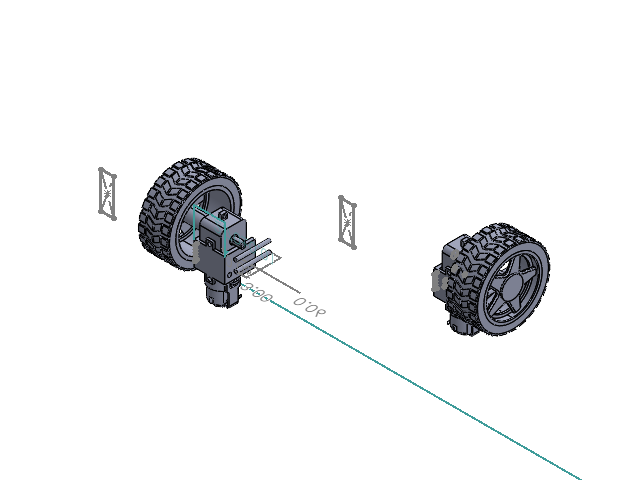
[picture p61: CAD file, 2026-05-18]
May 4 Monday/E1/draft/Assem1.SLDASM
motor with tire
motor with tire2
motor-front x 2
