yongyuxuuni/Prototyping/(list of files, cad)

Other CAD files:
Design/E1/draft/new /battery holder.SLDPRT
Design/E1/E1-STP /E1-ultrasonic holder.STEP
Design/E1/E1-STP /E1-motor holder.STEP
Design/E1/E1-STP /E1-ir sensor holder.STEP
Design/E1/E1-STL/E1-battery holder.STL
Design/E1/E1-STL/E1-ir sensor holder.STL
Design/E1/E1-STL/E1-motor holder.STL
Design/E1/E1-STL/E1-ultrasonic holder.STL
Design/E1/draft/old /P06_TA3_Servo_holder.SLDPRT
Design/E1/draft/old /P11_TA3_Battery_holder_backt side support 2.SLDPRT
Design/E1/draft/old /battery holder.SLDPRT
Design/E1/draft/old /ir sensor holder.SLDPRT
Design/E1/draft/old /motor holder.SLDPRT
Design/E1/draft/old /ultrasonic holder.SLDPRT
