yongyuxuuni/Prototyping/May 4 Monday/E1/draft/printing time-1h30min.png

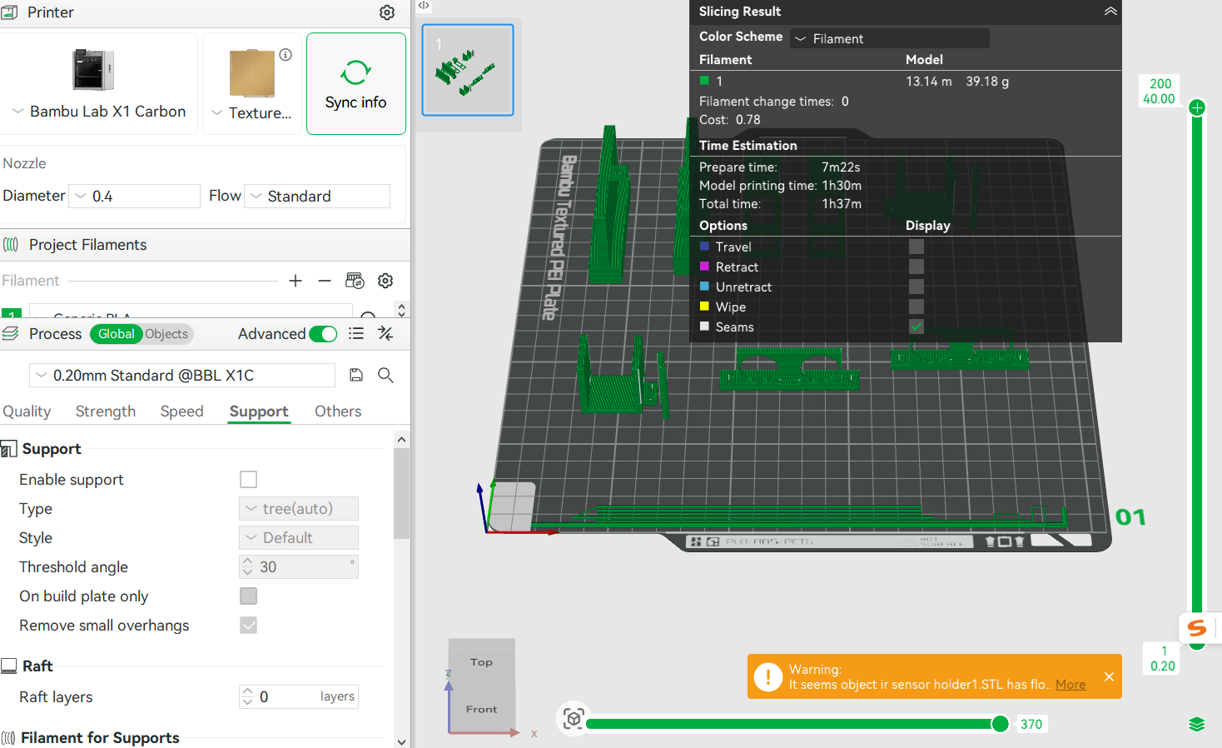
May 4 Monday/E1/draft/printing time-1h30min.png
