yongyuxuuni/Prototyping/(commit log)

2026-06-01 first prototype of vehicle (assembly)
2026-06-01 first prototype of vehicle (solidworks)
2026-06-01 first code draft in Tinkercad
    [first code draft in Tinkercad .brd]
2026-06-18 Rename Task 1/Use Case Diagram- Prototyping.png to Task 1/Use Case Diagram/Use Case Diagram- Prototyping.png
2026-06-18 Rename E1-battery holder.STL to E1-battery holder.STL
    [E1-battery holder.STL]
2026-06-18 Rename May 4 Monday/E1/E1-STL/E1-ir sensor holder.STL to Design/E1/E1-STLE1-ir sensor holder.STL
    [E1-STLE1-ir sensor holder.STL]
2026-06-18 Rename Design/E1/E1-STLE1-ir sensor holder.STL to Design/E1/E1-STL/E1-ir sensor holder.STL
    [E1-ir sensor holder.STL]
2026-06-18 Rename E1-motor holder.STL to E1-motor holder.STL
    [E1-motor holder.STL]
2026-06-18 Rename E1-ultrasonic holder.STL to E1-ultrasonic holder.STL
    [E1-ultrasonic holder.STL]
2026-06-18 Rename E1-battery holder.STEP to E1-battery holder.STEP
    [E1-battery holder.STEP]
2026-06-18 Rename E1-ir sensor holder.STEP to E1-ir sensor holder.STEP
    [E1-ir sensor holder.STEP]
2026-06-18 Rename E1-motor holder.STEP to E1-motor holder.STEP
    [E1-motor holder.STEP]
2026-06-18 Rename E1-ultrasonic holder.STEP to E1-ultrasonic holder.STEP
    [E1-ultrasonic holder.STEP]
2026-06-18 Rename battery holder.SLDPRT to battery holder.SLDPRT
    [battery holder.SLDPRT]
2026-06-18 Rename ir sensor holder.SLDPRT to ir sensor holder.SLDPRT
    [ir sensor holder.SLDPRT]
2026-06-18 Rename motor holder.SLDPRT to motor holder.SLDPRT
    [motor holder.SLDPRT]
2026-06-18 Rename ultrasonic holder.SLDPRT to ultrasonic holder.SLDPRT
    [ultrasonic holder.SLDPRT]
2026-06-18 Rename May 4 Monday/E1/draft/Assem1.SLDASM to Design/E1/draft/old/Assem1.SLDASM
    [Assem1.SLDASM]
2026-06-18 Rename May 4 Monday/E1/draft/Assemble.SLDASM to Design/E1/draft/old /Assemble.SLDASM
    [Assemble.SLDASM]
2026-06-18 Rename May 4 Monday/E1/draft/battery holder2.SLDPRT to Design/E1/draft/old /battery holder2.SLDPRT
    [battery holder2.SLDPRT]
2026-06-18 Rename May 4 Monday/E1/draft/ir sensor holder2.SLDPRT to Design/E1/draft/old /ir sensor holder2.SLDPRT
    [ir sensor holder2.SLDPRT]
2026-06-18 Rename May 4 Monday/E1/draft/motor-left.SLDPRT to Design/E1/draft/old /motor-left.SLDPRT
    [motor-left.SLDPRT]
2026-06-18 Rename May 4 Monday/E1/draft/motor-right.SLDPRT to Design/E1/draft/old /motor-right.SLDPRT
    [motor-right.SLDPRT]
2026-06-18 Rename May 4 Monday/E1/draft/printing time-1h30min.png to Design/E1/draft/old /printing time-1h30min.png
2026-06-18 Rename May 4 Monday/E1/draft/ul holder2.SLDPRT to Design/E1/draft/old /ul holder2.SLDPRT
    [ul holder2.SLDPRT]
2026-06-18 Rename P11_TA3_Battery_holder_backt side support 2.SLDPRT to P11_TA3_Battery_holder_backt side support 2.SLDPRT
    [P11_TA3_Battery_holder_backt side support 2.SLDPRT]
2026-06-18 Rename Task 1/Use Case Diagram/Use Case Diagram- Prototyping.png to Task 1/Diagrams/Use Case Diagram/Use Case Diagram- Prototyping.png
2026-06-18 Rename Task 1/first code draft in Tinkercad .brd to Task 1/codes/first code draft in Tinkercad .brd
    [first code draft in Tinkercad .brd]
2026-06-19 Add new Arduino sketch for Task 2
2026-07-03 motor control and update sensor configurations
2026-07-03 Task 2 Done : Obstacle Avoidance
    [Task2.ino]
2026-07-10 Rename Robot.pdf to Task 1/physical schematic/Robot.pdf
