yongyuxuuni/Prototyping/presentation/videos/02.jpg

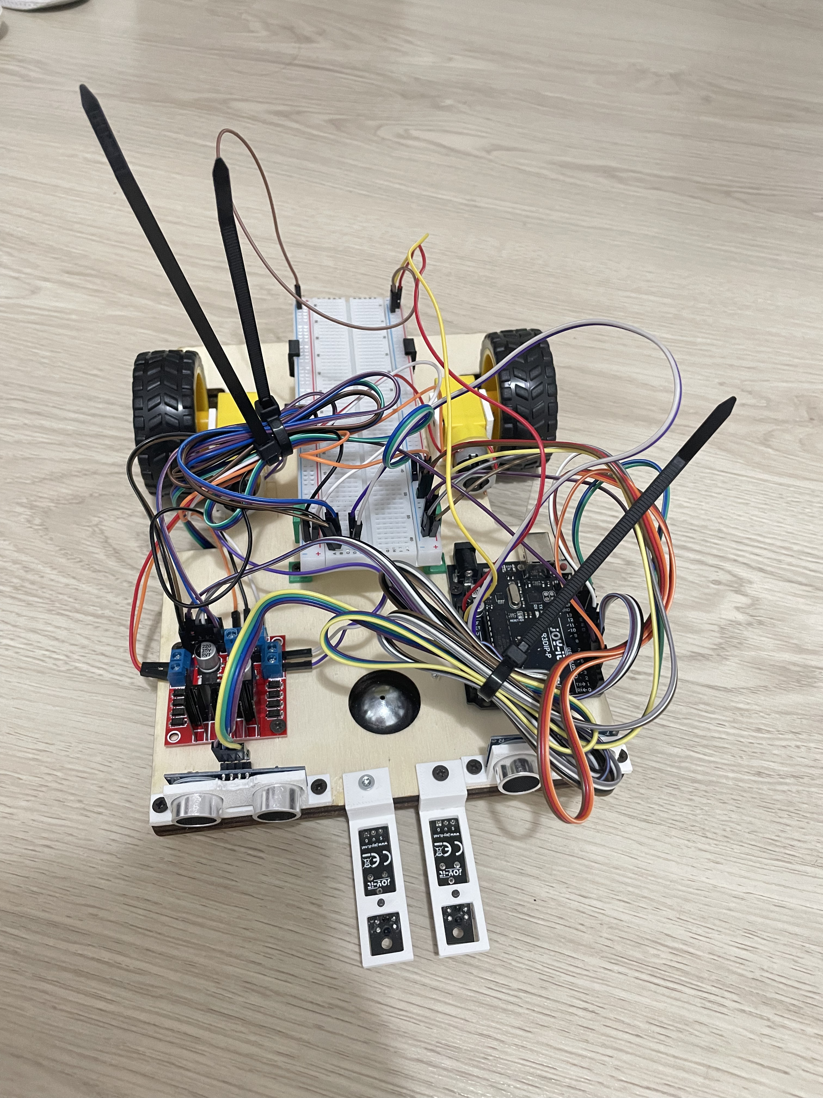
presentation/videos/02.jpg
